zen5x5/ebv-eye_snn_hardware/docs/related_work/2026_FPGA_SNN_Accelerator_Design_Review.md

# 硬件文献阅读入口

当前数值比较集中在 [Tan 与 FPGA 眼动追踪比较](../hardware/comparison.md)，当前数据流集中在 [设计报告](../hardware/current_design.md)。

## 架构参考

- [Tan 2025](https://doi.org/10.1109/TCSI.2025.3553497)：权重驻留、输入重用、计算单元附近保存部分和，帮助计算与存储带宽匹配。
- [SEE 2024](https://arxiv.org/html/2404.14279v1)：事件稀疏卷积在 FPGA 上运行，循环网络与读出在 Arm 上运行。
- [FireFly](https://doi.org/10.1109/TVLSI.2023.3279349)、[FireFly v2](https://arxiv.org/abs/2309.16158)：同为 XCZU3EG 器件族，适合研究并行计算与时间步调度；任务端点为分类。
- [ESDA](https://doi.org/10.1145/3626202.3637558)：稀疏坐标流、行缓冲和计算流水。

当前模型前两层使用事件与非零包流，深层使用共享的规则计算阵列。两步计算相邻执行时复用权重，L3 还复用卷积电流。当前布线资源和频率统一引用当前证据目录。

早期文献审计与设计空间说明保留在 Git 提交 3fef30e。
