zen5x5/ebv-eye_snn_hardware/docs/hardware/figures/ebv_eye_final_pe_bram_dataflow.pdf

EVENT-DRIVEN FRONT END | SHARED PAIRED-TIME BACK END | DENSE HEAD

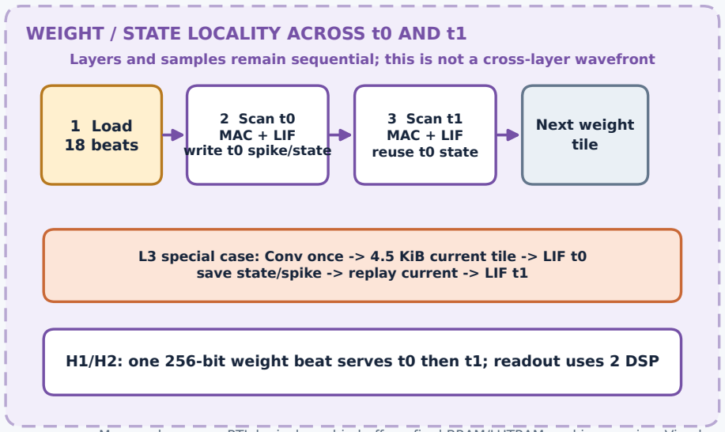
[picture p1: figure]
1 Load 18 beats; 2 Scan t0 MAC + LIF write t0 spike/state; 3 Scan t1 MAC + LIF reuse t0 state; Next weight tile

### WEIGHT / STATE LOCALITY ACROSS t0 AND t1

# EBV-Eye Final RTL: PE and On-Chip-Memory Dataflow

## Event-driven L1/L2, one shared 288-lane deep core, and adjacent t0/t1 execution

400 records

Pool -> constant -> S24 clamp -> stateless LIF

L3 reads once;
replay current

one physical core reused sequentially: L3 -> L4 -> ... -> L8

L4-L8: read previous A/B set; write the other set

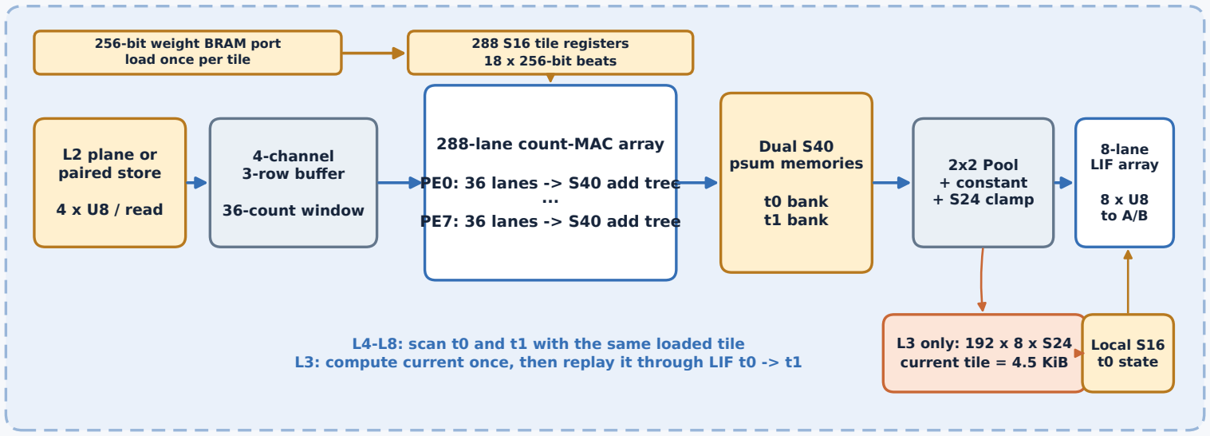
[picture p2: figure]
L2 plane or paired store; 4 x U8 / read; 4-channel 3-row buffer; 36-count window; 288-lane count-MAC array; PE0: 36 lanes -> S40 add tree ... PE7: 36 lanes -> S40 add tree; Dual S40 psum memories; t0 bank t1 bank; 2x2 Pool + constant + S24 clamp; 8-lane LIF array; 288 S16 tile registers 18 x 256-bit beats; 256-bit weight BRAM port load once per tile; L3 only: 192 x 8 x S24 current tile = 4.5 KiB; Local S16 t0 state

L4-L8: scan t0 and t1 with the same loaded tile
L3: compute current once, then replay it through LIF t0 -> t1

Layers and samples remain sequential; this is not a cross-layer wavefront

Memory boxes are RTL logical on-chip buffers; final BRAM/LUTRAM packing requires Vivado.

Sorted unit
events

(pol, row, col)

L1 event PE array

### 72 LUT add lanes 9 taps x 8 OC

Nonzero
U8 packet
FIFO

L2 count-MAC PEs

### 48 DSP lanes 3 taps x 16 OC

3-row / 9-bank S40 psum ring | 3-row / 9-bank S40 psum ring

L2 full plane

### 16 x 24 x 32

U8

### 8 x (2 U8)

banks

L3-L8 shared Conv PEs

### 8 output PEs 36 MAC lanes / PE 2 x S40 psum banks

= 288 DSP

Pool + constant
+ S24 clamp + LIF

S16 t0 state
L3: 4.5 KiB I tile

Paired U8
feature store

t0/t1 x A/B

### 4 sets x 8 banks

576 words/bank

H1 / H2
paired engine

### 16 DSP

Readout

2
DSP

Continuous
gaze

(x, y)

Front-end weight/config storage: L1 144 + L2 1,152 S16 weights | On-chip weight BRAMs -> 256-bit tile loader; parameter RAM -> postprocess

Layer controller / address generator / ready-valid scheduler

L3 special case: Conv once -> 4.5 KiB current tile -> LIF t0 save state/spike -> replay current -> LIF t1

H1/H2: one 256-bit weight beat serves t0 then t1; readout uses 2 DSP

Measured RTL/Yosys evidence | 354 DSP = 48 + 288 + 16 + 2 | 6,060 runtime 256-bit weight reads | 67,942.9 cycles/sample | 80.5 BRAM36-equivalent | 159,408 checked values, 0 mismatch
400 events | T = 2 | S16 W | S40 -> S24

## A Complete sample flow and memory hierarchy

B One deep-convolution tile: PE lanes and local buffers | C | Per-tile execution order
