zen5x5/ebv-eye_snn_hardware/docs/hardware/figures/ebv_eye_event_driven_layer_adjacent_architecture.pdf

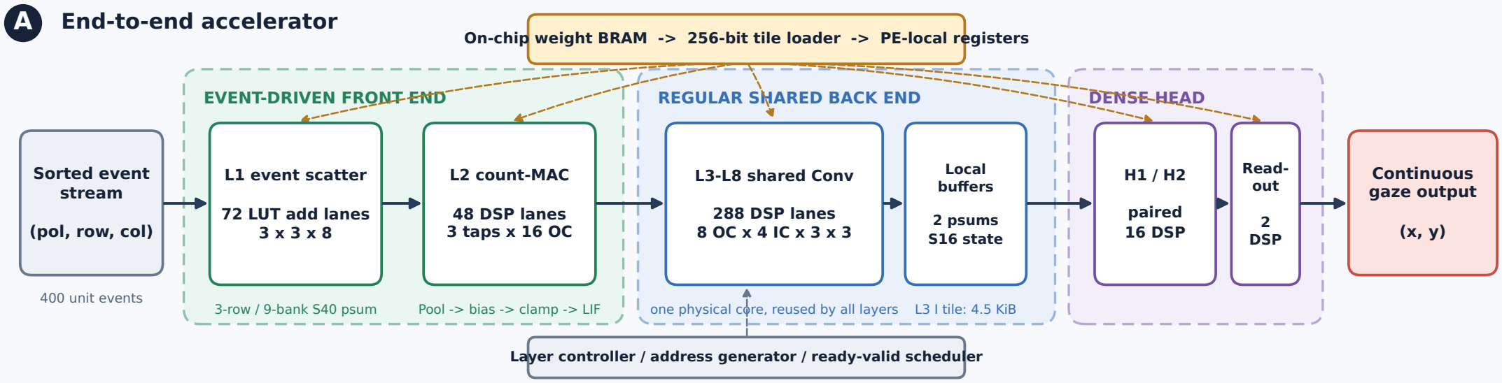
[picture p3: figure]
EVENT-DRIVEN FRONT END; REGULAR SHARED BACK END; DENSE HEAD; A End-to-end accelerator; 400 unit events; Sorted event stream; (pol, row, col); L1 event scatter; 72 LUT add lanes 3 x 3 x 8; L2 count-MAC; 48 DSP lanes 3 taps x 16 OC; L3-L8 shared Conv; 288 DSP lanes 8 OC x 4 IC x 3 x 3; Local buffers; 2 psums S16 state; paired 16 DSP; Read- out; 2 DSP; Continuous gaze output
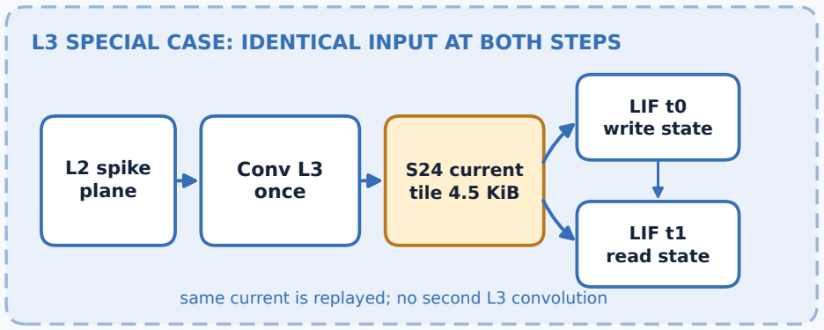
[picture p4: figure]
L2 spike plane; Conv L3 once; S24 current tile 4.5 KiB; LIF t0 write state; LIF t1 read state
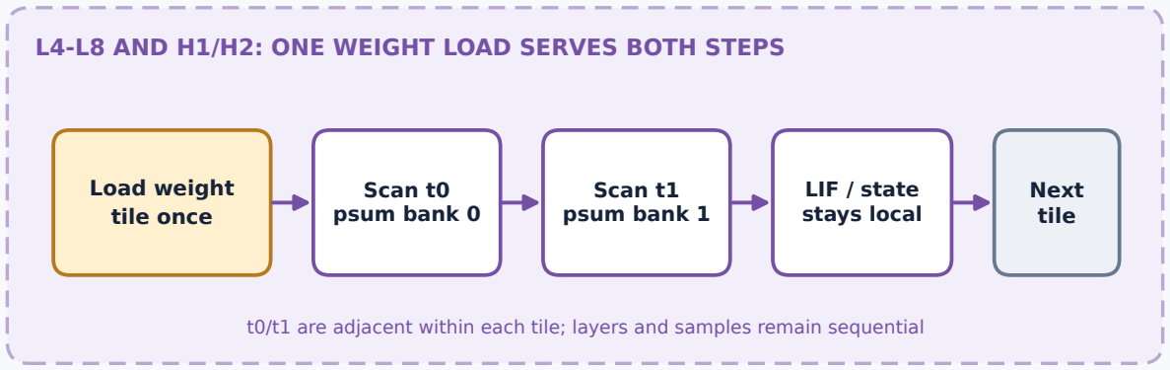
[picture p5: figure]
Load weight tile once; Scan t0 psum bank 0; Scan t1 psum bank 1; LIF / state stays local; Next tile

L3 SPECIAL CASE: IDENTICAL INPUT AT BOTH STEPS | L4-L8 AND H1/H2: ONE WEIGHT LOAD SERVES BOTH STEPS

# EBV-Eye SNN Accelerator

## Event-driven L1/L2 + per-layer adjacent t0/t1 execution

3-row / 9-bank S40 psum | Pool -> bias -> clamp -> LIF | one physical core, reused by all layers L3 I tile: 4.5 KiB

## B Deep-layer schedule: keep weights and state local across t0 / t1

same current is replayed; no second L3 convolution | t0/t1 are adjacent within each tile; layers and samples remain sequential

On-chip weight BRAM -> 256-bit tile loader -> PE-local registers

Layer controller / address generator / ready-valid scheduler

RTL evidence | 7.911M scheduled lanes | 67,942.9 cycles/sample | 345,080,448 checked values, 0 mismatch | Yosys: 354 DSP + 80.5 BRAM36-equivalent
400 events | T = 2 | S16 / S24
