zen5x5/ebv-eye_snn_hardware/docs/hardware/README.md

# 硬件报告

- [当前设计](current_design.md)：400 事件输入、L1 至输出的数据流、存储和逐模块资源。
- [性能比较](comparison.md)：2026-10-17 更新，收录 16 篇独立外部工作；7 篇 FPGA 实现或原型、8 篇 SNN 研究及 Tan 芯片，包含 Retina、NeuroEye 等硬件对照。
- [正式 48 模型量化](06_formal_l40s_quantization.md)：Pursuit/Saccade 各 24 用户的软件定点结果。
- [历史：上 Vivado 前](../history/pre_vivado_20261013.md)。
- [历史：器件实现与结构调整](../history/vivado_development_20261015.md)。
- [机器证据](../../evidence/README.md)与[复现检查](../../VALIDATION.md)。
