zen5x5/ebv-eye_snn_hardware/docs/paper_metrics.md

# 论文硬件指标检查（seed2021 四组真实训练模型）

2026-10-19新增第五档Pursuit L1～L4无状态：已完成定点参考、16输入RTL核验、综合、布局布线和
160MHz完整时序；68,293拍、0.426831ms、120块BRAM36等效。五档时间/BRAM统一取
`results/latency_bram.json`或`.csv`。以下功率和能量仍专指原四档，本轮未要求第五档功耗。

## ISCAS投稿要求与本篇实验范围

2026-10-17核对[ISCAS 2027征稿说明](https://2027.ieee-iscas.org/call-for-papers)及
[官方投稿要求](https://epapers2.org/iscas2027/ESR/authorinfo1.php)。普通论文要求原创研究；
公开要求没有规定所有硬件论文均须上板、流片或进行完整的延迟仿真。
已发表的[NeuroEye，ISCAS 2025](https://doi.org/10.1109/ISCAS56072.2025.11043272)
报告布局布线后的功率与能量评估。以下实验范围根据本篇无状态与计算复用的贡献确定。

本篇完成四组模型的数值正确性、FPGA布局布线、完整时序、资源和拍数比较，
并已完成真实输入活动驱动的功率/能量估算。功耗使用布线后的功能网表执行真实输入，
记录推理窗口内的实际线网活动；未加入逐线SDF传播延时，未捕获延迟差产生的短暂跳变。
四组采用相同的方法、频率、电压、温度与输入。
耗时的逐线延迟仿真已停止，额外产物按用户要求删除。

## 主表应呈现的结果

| 指标 | 当前证据 | 本轮安排 |
| --- | --- | --- |
| 浮点与定点角误差 | 四档×Pursuit/Saccade×24用户共192模型完整test量化齐全；逐用户等权均值见results/quantization/state_depth/results.json | 已补齐；141份新增CPU评估、51份已有结果核验复用 |
| FPGA型号、工具与数值位宽 | XCZU3EG-2、Vivado 2025.2.1、权重/膜16位、脉冲8位 | 四组保持相同 |
| LUT、FF、DSP、BRAM数量与占比 | 四组综合与布线后资源均已完成 | 已补齐 |
| 工作频率与完整时序检查 | 四组均已通过160 MHz建立、保持、脉宽与约束覆盖检查 | 已补齐，DCP独立复核也全部通过 |
| 核心拍数、每样本时间、串行服务率 | 四组16样本RTL核验，拍数固定，160 MHz时序通过 | 已按验证频率换算，输入传输单列 |
| 推理期间平均功率 | user10四组×相同16输入，64次布线后活动仿真及功耗报告已完成 | 已补齐；报告样本均值与变化范围 |
| 每样本能量 | 总能量402.257/331.583/285.527/258.212 µJ，动态与静态分列 | 已补齐；能量=推理期间平均功率×核心时间 |
| 无状态带来的节省 | 四组时间、存储、读写及能量均已核验 | L1～L2相对全状态省25.15%核心时间、28.45%BRAM、29.02%总能量 |

“信号活动记录”记录计算时每根线维持0/1的时间及变化次数，文件格式为SAIF。
本轮功率是布线后电路的工具估算，统计范围为FPGA芯片上的该实现；板卡供电电路、
外部存储、相机和主机功率需在后续整机测量中统计。

本轮活动仿真使用user10各自模型和已经核验的16个validation样本。
四组user10结果单列；24用户平均功耗不列入本篇必做实验。
同一固定电路的拍数、资源和时钟约束随用户切换保持不变，功耗随权重和输入活动变化。
主汇总见[summary.json](../results/summary.json)。
四档双任务24用户完整定点批次见[量化索引](../results/quantization/state_depth/results.json)。
2026-10-19在carbonite CPU完成待补项；浮点沿用原训练报告，定点每人覆盖完整test。

## 速度需要写清楚的范围

核心时间：输入和权重已在片上存储中，从启动计算到结果完成。
四组核心拍数分别为105305、90525、78817、72101。
本轮无跨样本重叠，频率除以核心拍数给出核心连续服务率。

当前32位评估总线每个输入值使用地址、数据各一条命令；24576个输入值共49152条命令。
160 MHz每拍传一条命令时，输入命令发送需要0.307200 ms。
权重/常量初始化共62462条命令：卷积4158×10、全连接1992×10、逐通道参数320×3、
读出小数位2条。初始化一次为0.3903875 ms，可在后续样本之间保留权重。
这些是当前评估接口的命令时间；完整启动/完成/结果读取还有寄存器接口延迟。

逐样本加载与核心计算顺序执行时，至少需要“49152条输入命令+核心拍数”；
完整接口样本间隔还应包含启动、完成确认和读回。这应和核心服务率分别列示。
事件收集400条需要的时间随事件发生速度变化，属于系统输入成窗时间，单独报告。

## 对无状态创新特别有用的补充表

列出每组每层拍数、膜电位容量和每样本读写字节数，直接说明节省发生在哪里。
RTL现已逐层核对状态读写次数和乘加发射次数，可以从记录生成该表。
同时列出为跨步复用保留的电流、特征及部分和缓存，给出整个实现的BRAM总量。
外部论文对比统一标注输出任务、输入窗口、平台、精度、时间范围及验证阶段。

## 本篇选定完成阶段

本篇采用FPGA布局布线和完整时序检查，加真实输入活动的功耗/能量估算。
板上运行与供电测量按用户决定安排到后续期刊扩展。
上述主表用于验证本篇的精度、时间、存储和能量结论。实际最高频率搜索、GOPS峰值、
ASIC流片与板级实测留在本轮范围之外。

方法参考：[AMD UG907：基于SAIF的功耗分析](https://docs.amd.com/r/en-US/ug907-vivado-power-analysis-optimization/Vector-SAIF-Based-Power-Analysis)。
