zen5x5/ebv-eye_snn_hardware/docs/hardware/current_design.md

# 当前硬件设计

更新：2026-10-16。部署候选为 Pursuit user17/seed2022。源代码在 `code/hardware/rtl/`，完整顶层为 `pursuit_sparse_layer_major_accelerator_top.sv`。

## 输入和模型

一个样本连续取得 400 个眼部 ROI 事件。ROI 为 192×256，坐标各除以 2 后，形成 96×128 空间中的两个极性通道。重复地址保留重复事件，送入前按行号排列。

同一完整输入用于两个逻辑时间步 t0、t1。每个逻辑步包含大量 FPGA 时钟。L1/L2 从零状态开始，输出供两个时间步使用；L3 至 H2 保存第一步留下的膜电位。

| 层 | 结构 | 输出尺寸 |
|---|---|---|
| L1 | 2→8，3×3 卷积、2×2 池化、脉冲计算 | 8×48×64 |
| L2 | 8→16，同上 | 16×24×32 |
| L3 | 16→24，同上 | 24×12×16 |
| L4 | 24→32，同上 | 32×6×8 |
| L5 | 32→40，同上 | 40×3×4 |
| L6～L8 | 三层 40→40 卷积、脉冲计算 | 40×3×4 |
| H1、H2 | 脉冲全连接 480→60→12 | 60、12 |
| 输出 | 两步脉冲取均值，12→2 线性读出 | 连续坐标 x、y |

参数总数 96,792。权重为有正负号的 16 位整数，运行部分和为 40 位，电流为 24 位，膜电位为 16 位，脉冲计数为无符号 8 位。

当前 user17 模型在 1,364 个 test 样本上的浮点/定点平均角误差为 0.489147°/0.488592°。该候选按 72 个已训练模型各自 test 误差排序选取，各用户数据不同。正式多用户报告另列 Pursuit/Saccade 各 24 用户等权定点误差 0.825481°/1.326037°。

## 完整数据通路

当前数据通路

1. 主机提前装入权重、每通道常量和小数位设置。
2. L1 消费 400 个单位事件，按权重更新局部卷积部分和，完成池化与脉冲计算，发送非零计数包。
3. L2 对每个非零包执行计数乘权重，再做池化、加常量和脉冲计算，保存完整 16×24×32 输出。
4. L3 对每个 8 输出通道块计算一次卷积电流，放入 4.5 KiB 缓存，连续用于两个时间步的神经元计算。
5. L4～L8 共用同一卷积引擎。每个权重块装入后，依次扫描第一步、第二步输入；两套部分和、局部膜电位与两步特征存储配合保存中间结果。
6. H1/H2 共用 16 路整数计算引擎，每组权重相邻服务两个时间步。
7. 输出层形成两维有符号 64 位整数及缩放设置，外部按小数位和时间步平均系数换算连续坐标。

各深层顺序使用共享引擎，样本按顺序处理。

## L1：事件、计算和存储的顺序

### 接收和加权累加

L1 接收行 7 位、列 7 位、极性 1 位，合计 15 位事件数据。寄存器还保存列号除以 3 的商/余数（6/2 位）、行号余数（2 位）和卷积核组号（4 位）。

144 个 S16 权重共 288 字节，分成 24 个深度为 6 的小存储；8 个常量及小数位设置共 232 位。

24 路加法每次更新 3 个空间位置、每位置 8 个通道。三组覆盖 3×3 支持域；每组先花 1 拍从 BRAM 读出旧值，下一拍加权并写回，所以每事件的更新过程为 6 拍。160 MHz 下为 37.5 ns。

每个位置的 8 个 S40 部分和组成 320 位数据字。三行按行号和列号除以 3 的余数分成 9 个存储组，每组 43 个地址：

```text
组号 = 3 × (行 % 3) + 列 % 3
地址 = 列 // 3
容量 = 9 × 43 × 320 位 = 15,480 字节
```

本次 Vivado 将该累加区安排为 36 RAMB36 + 9 RAMB18，标称容量合计 182.25 KiB。宽数据字和多组并行访问占用了整块存储器。

### 按行池化和脉冲计算

一行卷积值完成后，电路读出相邻两个位置，8 个通道一起比较。上行的横向最大值放入 64×320 位的 LUT 小存储，容量 2.5 KiB；下行到达后完成纵向比较。8 个池化结果保存到 320 位寄存器，下一拍完成加常量、24 位钳位、脉冲和剩余膜电位计算。

位置输出寄存器保存电流 192 位、脉冲 64 位和膜电位 128 位，共 384 位数据。发送寄存器保存脉冲 64 位、地址 12 位、非零通道标记 8 位和发送状态 1 位。非零通道依次以 23 位包交给 L2，接收端忙时保留待发数据。

本次样本的第一个事件为行 1、列 55、极性 0。第 7 输出通道在池化位置 (0,27) 的四个卷积值为 5317、26534、9189、-10898；取最大值得 26534，加常量 927 得 27461。该通道阈值整数为 4096，得到计数 6 和剩余膜电位 2885。

### 本次样本的实测拍数

| 阶段 | 拍数 |
|---|---:|
| 清空累加区 | 43 |
| 输入与换行控制等待 | 156 |
| 事件读取、加法和写回 | 2,400 |
| 读取池化位置 | 6,144 |
| 池化及等待输出腾空 | 35,405 |
| 脉冲计算 | 3,072 |
| 行末输出收尾及外围结束 | 100 |
| L1 合计 | 47,320 |

L1 与 L2 连在一起运行时历时 295.75 µs。该样本有 362 个不同的极性位置，L1 输出 24,576 个计数，其中 3,315 个非零；包内计数总和为 8,728。独立 L1、下游持续接收的测试为 19,816 拍。

## L2 与深层的当前实现

L2 有 48 路 U8 计数乘 S16 权重的运算，16 个输出通道共用一套脉冲计算电路。其 9 个累加存储组每组 22×640 位，共 15.47 KiB，映射为 LUT 分布式存储。完整 L2 脉冲图为 12 KiB，保存在 BRAM，供 L3 读取。

深层卷积阵列每次处理 8 个输出通道、4 个输入通道和 9 个卷积位置，共 288 路乘法。整个共享卷积引擎布线后合计 308 DSP。H1/H2 有 16 路整数计算，输出有 2 路点积计算；本次工具把这两部分安排到 LUT。

两步特征由 t0/t1 × A/B 四组存储保存，逻辑容量共 18 KiB。L3 电流缓存为 4.5 KiB。每样本运行期读取 6,060 个 256 位权重数据字，包含卷积 4,068、线性 1,980、输出 12 次。

## 当前资源、时间和功率

| 模块 | LUT | FF | RAMB36 | RAMB18 | DSP |
|---|---:|---:|---:|---:|---:|
| L1 | 8,842 | 1,523 | 36 | 9 | 0 |
| L2 | 24,466 | 7,519 | 9 | 8 | 0 |
| 共享卷积引擎 | 16,641 | 10,962 | 29 | 3 | 308 |
| 两步特征存储 | 1,791 | 6 | 0 | 32 | 0 |
| H1/H2 引擎 | 9,176 | 2,885 | 0 | 0 | 0 |
| 输出引擎 | 730 | 270 | 0 | 0 | 0 |
| 顶层合计 | 61,657 | 24,835 | 124 | 54 | 308 |

顶层还包含权重、参数和控制电路。LUT 可能跨模块合并，完整层级统计见原始资源报告。

```text
整网 = 104,005 拍
前端 = 51,305 拍；共享卷积 = 48,609 拍；全连接 = 4,074 拍
其余交接控制 = 17 拍

核心时间 = 104,005 / 160,000,000 = 0.65003125 ms
连续串行服务率 = 160,000,000 / 104,005 ≈ 1,538 次/秒
```

器件实现按 5 ns 目标布线，setup 余量 -1.109 ns；同一布线结果覆盖为 6.25 ns 后，setup/hold 余量为 +0.141/+0.040 ns。OOC 是单独实现加速器核心，板级接口留待集成。

Vivado 给出的总片上功率为 1.835 W，其中动态 1.608 W、静态 0.228 W，标记 Medium 置信度，采用默认活动估计。按该功率与核心时间相乘，每样本能量估算为 1.192807 mJ。板上活动和功率测量是后续确认这两项的步骤。

## 证据

- [整网功能回放与 L1 计数](../../evidence/current/rtl_replay/report.json)。
- [量化结果](../../evidence/current/quantization/pursuit/user17/summary.json)。
- [布线后资源](../../evidence/current/vivado/reports/post_route_utilization.rpt)。
- [160 MHz 时序](../../evidence/current/vivado/reports/post_route_timing_160mhz.rpt)。
- [工具功率](../../evidence/current/vivado/reports/post_route_power_vectorless_160mhz.rpt)。
- [对外性能比较](comparison.md)。
