zen5x5/ebv-eye_snn_hardware/docs/hardware/01_pursuit_l1_l2_stateless_pre_eda_design.md

# Pursuit L1/L2无状态SNN：上EDA前的语义、dataflow与验证方案

## 当前判断

最适合当前一周到三周时间窗的目标，是“定点参考＋真实尺寸关键浅层 RTL＋
同一映射下全状态/无状态综合对比＋真实输入回放计数”。首个公平对照应采用
同一套时间优先 dataflow：全状态模型和 L1/L2 无状态模型都计算两个时间步，
只改变跨步膜的保留与访问。重复输入带来的计算复用另列为第二个优化结果，
避免把状态删除与 dataflow 优化混成一个数字。

截至 2026-10-06，已完成上 EDA 前的模型语义核对、逐层存储账、候选
dataflow、验证边界，以及 3 个 seed × 2 种状态配置 × train/validation 的
12 组浮点数值范围审计。用户已确认先做FS-TM/SL-TM公平对照，再增加SL-HYB
复用；层内驻留、稀疏性和PE设计空间见[02文档](02_pursuit_dataflow_pe_and_channel_design_space.md)。
train 部分扫描的是正式缓存中的物理来源窗，不是
训练时逐 epoch 随机生成的 200+200 重组样本。本文件保留冻结前设计依据；
后续已经完成S16/S24/S16定点、两套golden vectors、完整L1～readout RTL、
FS-TM/SL-TM/SL-HYB状态机和整网逐值回放，见[03文档](03_pursuit_fixed_point_and_parallel_core.md)
与[04文档](04_pursuit_complete_pre_vivado_rtl.md)。2026-10-08又实现L1/L2
事件驱动的Sparse-TM及层内相邻两步的Sparse-LM-A，见
[05文档](05_pursuit_sparse_frontend_and_layer_major_rtl.md)。本文保留最初的
设计与验证依据；当前仍没有Vivado布局布线、WNS、功耗或上板数字。

## 固定的推理合同

每个样本由 ROI 内 400 个事件形成 `2×96×128` 双极性计数图，在两个内部
逻辑步 `t0,t1` 完整重复。每个新样本开始前清空全部膜状态；两个逻辑步不是
两个 FPGA 时钟，也不是两批新事件。

卷积层 L1～L5 为 `Conv(no bias)→BN→MaxPool→LIF`，L6～L8 为
`Conv(no bias)→BN→LIF`。随后是 `480→60→12` 两个脉冲全连接层；H2 的两个
时间步脉冲先精确除以 2，再送入无 bias 的 `12→2` 连续读出。

将 BN 输出和阈值归一化后的当前步电流记为 `I_t`，逐神经元语义为：

```text
u_t = 0.75 * v_(t-1) + I_t
s_t = max(floor(u_t), 0)
v_t = max(u_t - s_t, -1)
```

`s_t` 是非负整数 MultiSpike 计数，没有由模型定义的有限上界。L1/L2 在
`t0→t1` 边界清空膜，其他层保留；因此 L1/L2 对两个重复输入必须产生完全
相同的输出。L1/L2 的 `t1` 后残余膜没有消费者，硬件无需物化。训练使用的
PeriodicExponential surrogate gradient 不进入推理电路。

对每个输出通道，BN、阈值和无 bias 卷积可折叠为：

```text
a  = gamma / (sqrt(running_var + eps) * theta)
W' = a * W
b' = (beta - gamma * running_mean / sqrt(running_var + eps)) / theta
```

所以原卷积没有 bias，不表示电路没有逐通道常量 `b'`。前五层仍必须保持
“完成本步卷积与归一化电流→MaxPool→LIF”的顺序。

## 逐层尺寸、参数和跨步状态

下表的“卷积/线性输出”与“LIF位置”均是单个逻辑步的元素数。常量是折叠后
每个输出通道或神经元一个；参数均不含膜状态。

| 层 | 卷积/线性输出 | Pool后/LIF位置 | 权重 | 折叠常量 | 全状态跨步膜 | 最终跨步膜 |
|---|---:|---:|---:|---:|---:|---:|
| 输入 | 24,576 | 24,576 | 0 | 0 | 0 | 0 |
| L1, 2→8 | 98,304 | 24,576 | 144 | 8 | 24,576 | 0 |
| L2, 8→16 | 49,152 | 12,288 | 1,152 | 16 | 12,288 | 0 |
| L3, 16→24 | 18,432 | 4,608 | 3,456 | 24 | 4,608 | 4,608 |
| L4, 24→32 | 6,144 | 1,536 | 6,912 | 32 | 1,536 | 1,536 |
| L5, 32→40 | 1,920 | 480 | 11,520 | 40 | 480 | 480 |
| L6, 40→40 | 480 | 480 | 14,400 | 40 | 480 | 480 |
| L7, 40→40 | 480 | 480 | 14,400 | 40 | 480 | 480 |
| L8, 40→40 | 480 | 480 | 14,400 | 40 | 480 | 480 |
| H1, 480→60 | 60 | 60 | 28,800 | 60 | 60 | 60 |
| H2, 60→12 | 12 | 12 | 720 | 12 | 12 | 12 |
| Readout, 12→2 | 2 | 2 | 24 | 0 | 0 | 0 |
| **合计** | — | — | **95,928** | **312** | **45,000** | **8,136** |

若权重和常量暂按 16 bit，95,928 个权重加 312 个常量共 187.97 KiB；这只是
容量换算，不代表最终 BRAM 映射。跨步膜按 16 bit 时，全状态为 87.89 KiB，
最终模型为 15.89 KiB。时间优先且边界一次写加一次读时，相应跨步膜流量为
175.78 KiB/样本和 31.78 KiB/样本，差值 144 KiB。该差值只属于这项映射
假设，不能写成总存储或总能耗下降 81.92%。

## 公平对照与计算复用

建议按三档分别实现和报告：

| 名称 | 调度 | 两步浅层计算 | 跨步状态 | 用途 |
|---|---|---|---|---|
| FS-TM | `t0`整网后`t1`整网 | 都执行 | L1～H2，共45,000 | 全状态基线 |
| SL-TM | 与FS-TM完全相同 | 都执行 | L3～H2，共8,136 | 单独测状态删除收益 |
| SL-HYB | `t0`算浅层并缓存边界，`t1`复用 | 复用L1/L2前缀 | L3～H2，共8,136 | 单列重复输入优化 |

全状态模型也应获得重复输入允许的优化：它可以缓存 L1 的当前步输入电流，
但因 L1 膜保留，不能直接复用 L1 脉冲。最终无状态模型的 L1、L2 输出均在
两步相同，可选择两个复用边界：

- 缓存 L2 脉冲：容量为 `12,288*b_s` bit，即 `1,536*b_s` byte；若脉冲计数
  为 8 bit，需要 12 KiB。
- 缓存 L3 的 Pool 后、LIF 前电流：容量为 `4,608*b_i` bit，即
  `576*b_i` byte；若电流为 16 bit，需要 9 KiB，并能跳过第二步从输入到
  L3 电流生成的全部计算。

L3 电流缓存小于 L2 脉冲缓存的条件是 `b_i < (8/3)*b_s`。位宽未冻结前，
不能只凭示例确定边界。

整网单步稠密 Conv＋Linear 为 10.391M MAC，两步为约 20.781M MAC。缓存 L3
电流可省去第二步 L1～L3 的 7.963M 稠密 MAC。按现有脉冲活动估算，原始两步
SynOps 为 7.290±0.447M；缓存 L2 脉冲后约 6.476±0.368M，缓存 L3 电流后约
5.196±0.258M。这些数值不是周期、功耗或 FPGA 实测。

纯粹按层处理两个时间步可以把每层状态局部化，但会引入两步激活缓存，并使
45,000→8,136 的物理 RAM 对比依赖另一套映射。它可作为 dataflow 敏感性
分析，不适合作为唯一的全状态/无状态比较。

## 空间计算与首版核心

一周版本建议使用规则的分块稠密共享卷积核心，首个候选输出通道并行度为
`P_OC=8`。原因是它能先建立确定的周期、RAM 和时序账，并覆盖真实的
L1→L2→L3 尺寸。若直接把 SynOps 映射成稀疏 scatter，仍需提供部分和/当前
累加器、地址路由和输出初始化；折叠常量还可能使没有输入脉冲的位置发放，
因此不能假设“无事件就完全不访问输出”。稀疏版本可在规则核心正确后评估。

候选模块边界为：

```text
input loader
  -> scheduler
  -> shared conv + folded affine + pool
  -> MultiSpike LIF
  -> ping-pong activation RAM
  -> H1/H2 + temporal mean + readout

state RAM: FS存L1～H2；SL存L3～H2
perf monitor: 周期、状态读写、激活读写、权重读、有效累加
```

可综合核心保持器件无关，另设 `core_synth_top`；AUP-ZU3 回放另设
`aup_zu3_replay_top`，以后需要 PS/AXI 时再加 wrapper。这样行为仿真不依赖
板卡文件，综合和布局布线才绑定具体器件。

## 浮点数值范围审计

审计扫描 3 个 seed 的全状态 epoch100 与 L1/L2 无状态续训 epoch200，分别
覆盖正式缓存中的物理 train 来源窗和 validation，共 12 组；它不生成训练时
的逐 epoch 随机重组样本。位宽校准不读取 test。下表给出所有 12 组的并集
极值；`I`、`u` 和 `v` 均在阈值归一化域。逐 seed 原始 JSON 保存在
`/data/xuzx/result/ebv-eye/pursuit/fixed_event_window/hardware/numeric_range_profile_20261006/`；
每份均记录分析脚本、checkpoint、configuration 和缓存 SHA-256。

| 层 | `I_min` | `I_max` | `u_min` | `u_max` | 复位后`v` | 最大MultiSpike |
|---|---:|---:|---:|---:|---:|---:|
| L1 | -95.3456 | 173.3320 | -96.0424 | 173.3320 | [-1, 1) | 173 |
| L2 | -101.4628 | 123.6798 | -101.4628 | 123.6798 | [-1, 1) | 123 |
| L3 | -64.3635 | 62.3081 | -65.1135 | 62.5392 | [-1, 1) | 62 |
| L4 | -25.6895 | 62.5325 | -26.4395 | 62.8771 | [-1, 1) | 62 |
| L5 | -10.0655 | 34.4135 | -10.8155 | 35.0256 | [-1, 1) | 35 |
| L6 | -22.1116 | 18.6504 | -22.8616 | 18.6504 | [-1, 1) | 18 |
| L7 | -19.1210 | 14.5445 | -19.8710 | 15.1159 | [-1, 1) | 15 |
| L8 | -7.0105 | 6.7712 | -7.7605 | 7.1810 | [-1, 1) | 7 |
| H1 | -55.2900 | 71.4315 | -56.0400 | 72.0430 | [-1, 1) | 72 |
| H2 | -35.5900 | 68.8574 | -36.3400 | 68.9531 | [-1, 1) | 68 |

输入每像素计数在 train/validation 的并集最大值为 29；接口仍应按每个样本
最多 400 个事件的理论上界保留 U9，除非后续明确采用饱和协议。校准集里的
最大脉冲计数 173 可装入 U8，但 MultiSpike 在模型定义上无界，因此还需用
定点累加器上界、饱和规则和误差实验共同冻结脉冲位宽。

折叠参数的三 seed、两状态模型并集如下：

| 层 | `theta_min..max` | `W'_min..max` | `b'_min..max` |
|---|---:|---:|---:|
| L1 | 0.89614..1.18414 | -4.22894..4.92700 | -0.40976..0.69614 |
| L2 | 0.53282..1.16754 | -0.46329..0.42531 | -0.46614..2.33728 |
| L3 | 0.51734..1.19223 | -0.45321..0.31703 | -1.96495..3.64654 |
| L4 | 0.64953..1.03954 | -0.48768..0.34393 | -0.96559..4.39539 |
| L5 | 0.69357..0.94420 | -0.26198..0.26632 | -1.51601..2.72415 |
| L6 | 0.55276..0.92909 | -0.25532..0.23085 | -2.76274..2.95681 |
| L7 | 0.56251..1.06845 | -0.60105..0.28892 | -1.46836..3.59475 |
| L8 | 0.73361..1.03478 | -0.28315..0.12863 | 0.27142..2.77898 |
| H1 | 0.71188..1.45369 | -2.48261..0.92398 | -0.12096..0.47369 |
| H2 | 1.00252..1.78465 | -1.18707..0.27326 | -0.12995..0.44882 |
| Readout | — | -0.16771..0.14402 | — |

L1 与深层的权重范围相差明显，首轮定点设计应比较逐层或逐输出通道 scale，
不宜直接假设一个全局 scale 足够。

范围脚本用便携的 CPU Sinabs 后端。它的三 seed validation 均值与已保存的
Exodus GPU 端点存在小差异：最终无状态模型为 14.872±0.376 px、
0.7466±0.0226°，已保存端点为 14.75±0.27 px、0.740±0.015°；全状态模型
分别为 14.852±0.619 px、0.7397±0.0263° 与 14.83±0.30 px、
0.740±0.012°。因此当前脚本只用于范围审计。生成 bit-exact golden vector 前，
必须明确冻结数学参考，并用同一参考报告定点误差。

## AUP-ZU3和工具边界

目标板为 RealDigital AUP-ZU3，器件固定为 `XCZU3EG-2SFVC784E`。本阶段最初
建议用板载100 MHz PL时钟起步；后续完整RTL的Vivado OOC目标已锁定5 ns，
200 MHz只在布局布线WNS非负后成立。AMD 的
[AUP-ZU3页面](https://www.amd.com/de/corporate/university-program/aup-boards/realdigital-aup-zu3.html)
给出 154K logic cells、360 DSP 和 9.4 Mb 片上 RAM；
[官方板卡仓库](https://github.com/Xilinx/AUP-ZU3)当前参考工程使用 Vivado
2024.1。Vivado Basic 支持 XCZU3EG。

2026-10-06进入本阶段时服务器尚未发现Vivado或开源RTL工具；随后已建立独立
环境并完成Icarus、Verilator和Yosys验收。当前服务器仍无Vivado。器件相关综合、
实现和时序需要有Vivado的机器，上板只承担最后的真实回放验证；当前目标不需要
ASIC EDA。

## 验证产物与验收条件

定点参考需输出 NPZ、逐端口 MEM 和 manifest。manifest 至少记录 checkpoint、
configuration、缓存和各向量的 SHA-256，张量布局、定点格式、舍入、饱和、
alpha0.75 计算顺序，以及 FS/SL 模式。首轮向量建议使用 16 个 validation 样本，
再加全零、边界值和最大输入等合成样本。

RTL 与参考的验收条件为：

1. 每层脉冲、保留膜和最终 gaze 定点结果逐项 bit-exact；
2. FS/SL 在相同位宽、PE 数、时钟和 RAM 推断方式下比较；
3. 状态读写计数与 45,000/8,136 元素账一致，其他 RAM 流量分项报告；
4. 对 `xczu3eg-sfvc784-2-e` 完成综合和布局布线，100 MHz 下
   `WNS>=0`、`WHS>=0`，无未约束路径和 error DRC；
5. 资源报告列 LUT、FF、BRAM、URAM、DSP，延迟列周期与换算时间；功耗若只有
   工具估计，明确输入活动和估计范围。

## 时间范围

一周可争取完成：定点语义与位宽基线、golden vector、真实尺寸 L1→L3 核心、
FS-TM/SL-TM bit-exact 仿真、状态/访存计数，以及同器件综合；若时序顺利，再
做布局布线。两至三周可继续整网调度、SL-HYB 复用、更多位宽对照、完整实现
后的时序与功耗估计，以及 AUP-ZU3 离线回放。传感器实时接入和 ASIC 物理设计
不属于当前时间窗。

这是2026-10-06当时确认的实施顺序：规则分块共享卷积核心先做FS-TM/SL-TM
公平对照，再增加L3输入缓存的SL-HYB；随后完成的Sparse-TM与Sparse-LM-A
及其当前证据见05文档。`P_OC=8`仍是已实现设计点，不写成跨设计空间测得的
全局最优点。
