zen5x5/ebv-eye_snn_hardware/docs/hardware/02_pursuit_dataflow_pe_and_channel_design_space.md

# Pursuit硬件dataflow、PE与逐通道设计空间

## 当前结论

2026-10-08论文写作补充：共享raster RTL保留为位精确、状态RAM与跨步复用
对照基线；随后已实现“浅层稀疏、深层规则”的`Sparse-TM`，以及让深层每个
权重tile相邻服务`t0/t1`的`Sparse-LM-A`方案A。方案A是单个共享核心的层内
时间复用，不是跨层波前。三路线正式对照见05报告；下文早期“下一步只剩
Vivado”的描述只适用于当时的稠密基线。

FS-TM、SL-TM和SL-HYB只描述两个SNN逻辑步怎样安排，用来区分“删除状态”与
“复用重复计算”。它们不是完整的卷积dataflow。完整设计还需决定八个卷积层
循环的顺序、每类数据驻留位置、片上RAM分 bank、稀疏调度以及PE并行维度。

当前建议采用分层混合驻留，而不是只选一种教科书标签：

1. 整网95,928个权重驻留片上BRAM；
2. 当前层输入使用3行缓冲，重复利用重叠的3×3窗口；
3. 当前输出通道的部分和驻留PE寄存器，累加完成后才写出；
4. 当前输出通道组的权重从分bank的片上权重RAM连续读取；
5. MaxPool边计算边归并，不保存完整的Pool前特征图；
6. 膜状态单独存储，FS保存L1～H2，SL只保存L3～H2；
7. 主论文比较保持时间优先，层优先作为dataflow敏感性分析；
8. L1/L2评估稀疏或跳零，L3以后先使用规则稠密调度。

当前还没有“必须使用多少PE”的唯一数字。一个乘法通道也能完成整网，只是很
慢；所需数量由目标计算延迟、100 MHz下的真实周期、RAM端口和Vivado资源共同
决定。早期32通道点只用于建立解析模型；位宽和微核审计后，首版已改为
完整3×3并行的`8/2/9`与`8/4/9`，即144/288个DSP乘法通道。前者是时序
回退，后者是速度目标，完整结果见03报告。

## “驻留”究竟是什么

卷积可以写成：

```text
for oy, ox, oc:
    psum = folded_constant[oc]
    for ic, ky, kx:
        psum += input[ic, oy+ky, ox+kx] * weight[oc, ic, ky, kx]
```

改变循环内外顺序，就会改变哪种数据能留在离计算器最近的位置：

| 名称 | 留在近端的数据 | 优点 | 本模型中的问题 |
|---|---|---|---|
| 权重驻留 | 当前权重块 | 同一权重跨空间位置重复使用 | 若输出通道块放最外层，输入特征图会为每个块重新扫描 |
| 输入驻留 | 当前输入窗口 | 一个3×3窗口可供全部输出通道使用 | 需要高带宽、分bank的权重RAM |
| 输出驻留 | 当前输出部分和 | 避免宽累加器反复读写RAM | 每个并行输出需要独立累加器 |
| 行驻留 | 3行输入及局部权重/部分和 | 同时利用窗口重叠和局部复用 | 控制和边界处理比纯循环更复杂 |

这些方式可以在不同存储层级同时存在。例如“整网权重驻留片上BRAM＋输入行驻留
line buffer＋输出部分和驻留PE寄存器”并不矛盾。论文需要写清驻留在哪一级，
不能只贴一个weight-stationary标签。

## 两种层内循环顺序

### 输出通道块在外：权重块更近

```text
for oc_tile:
    选择8个输出通道的权重
    for oy, ox:
        从行缓冲形成输入窗口
        在8个PE中完成部分和
```

它只需保存8个通道的权重块和Pool状态，控制简单；代价是每个输出通道块都要
重新扫描输入特征图。`P_OC=8`时，八个卷积层一个逻辑步共读取约143,904个源
特征元素；按16 bit为281.06 KiB，两个逻辑步为562.13 KiB。

### 空间窗口在外：输入窗口更近

```text
for oy, ox:
    输入窗口留在行缓冲
    for oc_tile:
        流入对应权重并完成8个输出部分和
```

一个逻辑步只需从激活RAM读取约69,024个源特征元素；按16 bit为134.81 KiB，
两个逻辑步为269.63 KiB。它减少约52%的这一级激活读取，但需要权重RAM持续
提供并行带宽，并为更多输出通道维护Pool行状态。当前最大Pool行缓存仍约2 KiB，
因此该方案值得在周期模型中优先比较。

以上都是片上流量，不是DDR流量。按当前16-bit容量账，整网权重和常量约
187.97 KiB；全状态时间优先方案连同激活缓冲和膜状态约371.86 KiB，最终
无状态约299.86 KiB，加入L3输入缓存约308.86 KiB。均低于AUP-ZU3公布的
9.4 Mb片上RAM总量，但还未计BRAM宽度、端口和碎片，必须由Vivado确认。

## 跨时间步调度

| 调度 | 权重复用 | 激活缓冲 | 状态物理化 | 论文用途 |
|---|---|---|---|---|
| FS-TM/SL-TM时间优先 | 每层在两个逻辑步各执行一次 | 单时间步ping-pong | 直接体现45,000/8,136个跨步状态 | 主公平对照 |
| 层优先 | 同一层连续处理`t0,t1`，权重更容易保留 | 通常需保存两步激活 | 当前层状态可局部保留，会弱化全局状态RAM差异 | dataflow敏感性分析 |
| SL-HYB | L1～L3输入生成一次 | 增加4,608个L3输入缓存 | 保留8,136个深层状态 | 无状态后的优化结果 |

层优先不是错误方案，但若只报告它，浅层膜状态本来就可能一直留在局部寄存器，
无法直接证明81.92%的逻辑状态删除变成相应物理RAM收益。因此主对照先用时间
优先，层优先再回答“换dataflow后结论是否仍成立”。

## 逐通道活动告诉我们的事情

统计覆盖最终L1/L2无状态模型的三个seed、426个validation物理样本。活动仅用于
硬件调度设计，不替代正式Exodus性能端点。

| 层 | 平均非零位置比例 | 单通道范围 | 最大通道/通道均值的脉冲负载 | 折叠权重逐输出通道最大幅值比 |
|---|---:|---:|---:|---:|
| L1 | 10.4% | 4.9%～15.2% | 1.67× | 2.3× |
| L2 | 30.2% | 10.3%～86.3% | 3.37× | 3.1× |
| L3 | 47.5% | 13.9%～86.0% | 2.49× | 4.8× |
| L4 | 52.8% | 18.8%～85.4% | 1.84× | 4.3× |
| L5 | 55.3% | 29.1%～78.4% | 1.54× | 2.0× |
| L6 | 30.4% | 18.5%～46.0% | 1.66× | 3.1× |
| L7 | 35.9% | 17.6%～46.4% | 1.78× | 6.7× |
| L8 | 32.8% | 8.9%～45.3% | 1.49× | 3.1× |
| H1 | 32.1% | 0%～100% | 6.24× | 33.7× |
| H2 | 29.6% | 0%～91.9% | 4.05× | 6.2× |

两个输入极性通道每个位置的非零比例只有1.13%和1.68%。现有活动分析还显示，
从输入脉冲扇出看，L1约79.9%的输出位置没有被突触触及，L2约57.1%，而L3
以后几乎所有位置都被触及。因此：

- 输入→L1以及L1→L2最值得评估事件驱动或跳零；
- L3以后单纯使用事件地址路由的收益较弱，规则稠密/零跳过更稳妥；
- L2逐源通道SynOps负载最大可达均值3.30倍，静态把一个活跃通道固定给一个PE
  会产生负载不均衡；稀疏方案需轮转、交错或工作队列；
- H1/H2在单个validation和seed中存在零发放通道，但不能凭此永久剪枝；共享PE
  可以动态跳过零输入，而不改变模型结构。

折叠后的浮点权重没有任何精确零，因此目前没有免费权重稀疏性。量化后出现的
零权重能否利用，要等定点实验，不能先假设。部分层的逐输出通道权重幅值相差
4～34倍，支持比较逐输出通道scale；但每个通道使用不同位宽会显著增加打包和
控制复杂度，首轮先保持每层统一位宽、逐输出通道scale或移位。

## 支撑L1/L2状态边界的观测（2026-10-08）

空间调度与状态保留分别由活动分布和容量—精度取舍支撑。这里整理已有模型的
统计，不新建监督缓存、不训练，也没有运行新的状态干预实验。

| 层 | 全状态架构中的膜元素数及占比 | 最终模型第一步非零位置 | 最终模型第二步非零位置 | 最终模型第一步/第二步发放量（脉冲单位/样本） |
|---|---:|---:|---:|---:|
| L1 | 24,576（54.61%） | 10.4% | 10.4% | 5,496.9 / 5,496.9 |
| L2 | 12,288（27.31%） | 30.2% | 30.2% | 6,126.8 / 6,126.8 |
| L3 | 4,608（10.24%） | 37.9% | 57.1% | 2,672.4 / 4,082.3 |

容量来自正式全状态架构，活动来自最终L1/L2无状态三seed模型在426个
user15 eye0 pursuit validation物理窗上的CPU Sinabs逐步剖析。
数据源为`channel_profile_20261006/l1_l2_stateless/seed2021～2023/validation.json`
中的`layer_statistics.Ln.spike_per_channel_by_timestep`：同层各通道的
`nonzero_fraction`取均值，再对三个seed等权平均；`sum_per_sample`先对通道
求和，再对三个seed平均。MultiSpike发放量按整数脉冲单位求和，不是非零位置数。

L1/L2两步无状态且输入重复，所以其脉冲逐值相同，L3归一化电流也相同。
L3第二步非零位置比例和发放量改变，因此这里确实存在由保留膜历史引起的
跨步整合；后面的层还同时受到上游脉冲变化影响，不能将其活动变化全部分配给
各层自身的膜。这个观测展示深层状态的实际表达作用，不将发放增多写成精度增益，
也不把最终模型浅层两步相同当作浅层状态原本无作用的证明。

选择L1/L2的直接依据是：两层集中81.92%全模型膜容量，已有同epoch100起点、
同200轮预算的三seed续训曲线在L1无状态后将L2无状态通道从0增到4/8/12/16，
validation角误差为0.741/0.763/0.757/0.743/0.740°，全状态参考0.740°。
因此整层边界在已测范围内取得最大容量削减、规则控制和相同validation精度。
保留的L3作为仅占10.24%原膜容量的首个深层积分阶段，能在相同电流下形成不同
的第二步表达。再深入删除状态属于另一取舍，不声称已测到L3及更深层的精度崩溃边界。

空间支持率的79.9%/57.1%来自既有`analysis/activity_validation.json`的
`per_layer.L1/L2.untouched_position_fraction`，按三seed等权平均得到
79.8864%/57.0957%。代码`convolution_touched_positions`先做3×3输入支持扩张，
再对有Pool的层做2×2支持合并，因此分母是Pool后的目标神经元位置，而不是
Pool前卷积部分和位置；L3～H2的未触及比例在这批统计中均为0。
未触及只表示没有上游非零输入扇出，折叠常量和保留膜仍需正确处理。

若后续需要进一步解释层间状态敏感性，建议只在现有全状态checkpoint的
validation上做逐层单独清状态的前向诊断，同时统计第二步膜历史改变的脉冲位置
比例和误差变化。使用user15三个seed即可，冻结权重、不重训；这仍是待讨论
分析，不作为已经完成的证据。

## PE怎样定义和选择

### PE是否必须含乘法器

不必须。模型中的输入计数和MultiSpike输出都是非负整数。对任意定点权重`w`和
脉冲计数`n`，突触贡献可以三种方式实现：

```text
乘法：          product = n * w
逐脉冲加法：    product = w + w + ... + w       共n次
二进制移位加法：product = sum(bit_i(n) * (w << i))
```

若使用足够宽的有符号累加器，并且只在最后统一舍入/饱和，三者可保持同一定点
数学结果。若每次加法都提前饱和，则逐脉冲实现可能与一次乘法不同，不能接受
这种隐式语义变化。

三seed最终无状态模型的全部validation活动给出以下每样本均值±样本标准差；
readout也按H2两步脉冲和累加权重、最后除以2的等价形式计入：

| 突触算术 | 原始T=2 | SL-HYB浅层复用后 | 需要通用乘法器 |
|---|---:|---:|---|
| 全稠密MAC | 20.781M | 12.819M | 是 |
| 非零计数×权重 | 4.196±0.268M | 3.037±0.165M | 是 |
| 二进制移位权重项 | 4.690±0.286M | 3.383±0.180M | 否，需移位与加法 |
| 逐单位脉冲加权累加 | 7.291±0.447M | 5.196±0.258M | 否，只需有符号加法 |

所以现有SynOps正好对应“逐单位脉冲加一次权重”的add-only实现。它比全稠密
MAC少很多操作，但相对“每个非零计数只乘一次权重”平均多约74%的突触操作；
二进制移位加法位于两者之间。操作个数仍不能直接换成周期或能量：DSP乘法可
流水到每拍一次，而事件加法还要支付地址路由、bank冲突和随机累加代价。

L1模型接口本身不是二值事件：400条传感器事件先按2×2空间SumPool映射地址，
再把重复`(x,y,polarity)`累加成`2×96×128`整数计数图；正式数据单位置可大于1。
因此L1和L2在卷积口的算术语义相同，都是整数`n`乘权重，不能仅凭层号决定
add-only或DSP。L1额外拥有一种输入表示选择：模型丢弃事件顺序和时间戳，硬件
可以不物化计数图，直接保存并消费400个池化后事件地址；每条记录贡献一次权重，
重复地址就重复累加，数学上严格等价于先构造计数图再算`n*w`。这种实现仍需
解决L1 Pool前累加器、重复地址、折叠常量和清零开销。

三seed validation在浅层复用后的每样本均值进一步说明选择应由工作量决定：
`input→L1`为28.679k次逐单位加法或24.711k次非零计数乘法，前者仅为后者
1.16倍；`L1→L2`则为785.234k次逐单位加法或364.499k次非零计数乘法，前者
为后者2.15倍。因而L2使用DSP计数乘法的吞吐动机更强，但这来自实际计数分布，
不是因为L1输入只能取0/1。

`alpha=0.75`也不需要通用乘法器，可实现为移位减法；H2时间平均是右移一位。
因此整网可以构造为add-only事件机器，但在有360个DSP48的AUP-ZU3上，强制
不用DSP不一定更快或更省。当前改为并行比较三种算术微架构，再决定L1/L2是否
使用add-only前端、深层是否使用计数乘权重核心。

下面原有`P_OC/P_IC/P_K`表描述的是乘法通道核心；add-only核心将另外报告加法
lane数、事件吞吐、累加器bank冲突和实际周期，二者不能共用一个“PE数量”。

“一个PE”没有统一行业定义。这里明确为：一个输出PE保留一个输出部分和，内部
含 `P_IC*P_K` 条乘法通道；共享核心共 `P_OC` 个输出PE，总乘法通道为：

```text
multiplier_lanes = P_OC * P_IC * P_K
```

- `P_OC`：同时计算的输出通道数；
- `P_IC`：每个输出PE每拍读取的输入通道数；
- `P_K`：每个输入通道每拍展开的3×3 kernel tap数。

解析模型枚举了47个不超过128条乘法通道的候选。下表使用100 MHz、权重/激活
16 bit、每条乘法通道暂按一个DSP48，只给MAC调度下界：

| P_OC | P_IC | P_K | 输出PE | 乘法通道/DSP假设 | FS/SL两步下界 | SL-HYB下界 | 算术通道利用率 |
|---:|---:|---:|---:|---:|---:|---:|---:|
| 4 | 2 | 1 | 4 | 8 | 25.98 ms | 16.02 ms | 100.0% |
| 8 | 2 | 1 | 8 | 16 | 12.99 ms | 8.01 ms | 100.0% |
| 8 | 4 | 1 | 8 | 32 | 7.60 ms | 4.56 ms | 85.4% |
| 8 | 2 | 3 | 8 | 48 | 4.33 ms | 2.67 ms | 100.0% |
| 8 | 4 | 3 | 8 | 96 | 2.53 ms | 1.52 ms | 85.4% |

`P_OC=8`适合卷积层，因为8、16、24、32、40都能整除8。32通道候选每拍需广播
4个16-bit激活、读取32个16-bit权重，并在8个32-bit部分和寄存器中累加；即
64-bit激活带宽和512-bit权重带宽。最大当前层权重块约5.63 KiB，最大3行输入
缓冲约3 KiB。48通道候选更快，但每拍权重带宽升到768 bit，RAM分bank和布线
更难。

因此“8个PE”指8个输出通道部分和，每个PE内部还有18或36条lane。当前实现
顺序为：先以`8/4/9`争取速度；若Vivado的WNS、DSP列布线或BRAM端口不成立，
同一RTL回退到`8/2/9`；最后以LUT、FF、BRAM、DSP、WNS和真实周期形成
Pareto表。

早期没有系统延迟目标时，16/32/48通道只是解析锚点。参考Tan的亚毫秒估计器
和用户要求的速度竞争性后，当前目标改为200 MHz附近计算低于1 ms，因此选择
144/288通道。完整L1闭环测得每次padded scan的总填充/排空开销为14拍；据此
校准后的200 MHz保守估计分别为1.003/0.595 ms。144-DSP点略高于1 ms，仍是
时序/布线回退；事件收满400个所需的传感器时间须与这些计算延迟分开报告。

## 实现状态

上述依赖已经全部实现到Vivado之前：同一个`P_OC/P_IC/P_K=8/4/9`核心覆盖
L1～L8，S40部分和RAM、H1/H2、readout、激活/状态RAM、L3电流缓存及
FS-TM/SL-TM/SL-HYB控制器均已接通。完整RTL对三条路线分别检查270,000、
270,000和159,408个值，均为零失配；周期为119,791、119,791和83,286。
冻结顶层使用288个卷积DSP、16个dense DSP和2个readout DSP，共306个。

稠密基线下一步只剩器件相关闭环：用Vivado对lean/full两个构建做综合与布局
布线，检查200 MHz WNS、实际RAM推断和拥塞。144-DSP结构仍是已分析的资源
回退方向，不是当前已经打包验证的第二个完整顶层。此后实现的L1 add-only、
L2 count-MAC稀疏前端已接入`Sparse-TM`与`Sparse-LM-A`两个完整顶层；两者与
稠密基线均有独立Vivado OOC入口，详见05报告和`code/hardware/vivado/README.md`。

机器结果位于：

- `/data/xuzx/result/ebv-eye/pursuit/fixed_event_window/hardware/channel_profile_20261006/`；
- `/data/xuzx/result/ebv-eye/pursuit/fixed_event_window/hardware/dataflow_design_space_20261006.json`；
- `/data/xuzx/result/ebv-eye/pursuit/fixed_event_window/hardware/synapse_arithmetic_comparison_20261006/`。
- `/data/xuzx/result/ebv-eye/pursuit/fixed_event_window/hardware/rtl_schedule_estimate_l1calibrated_20261006.json`。
- `/data/xuzx/result/ebv-eye/pursuit/fixed_event_window/hardware/rtl_microkernels_open_source_20261006/`。
- `/data/xuzx/result/ebv-eye/pursuit/fixed_event_window/hardware/rtl_core_open_source_20261006/`。
- `/data/xuzx/result/ebv-eye/pursuit/fixed_event_window/hardware/rtl_l1_streaming_golden_20261006/`。
- `/data/xuzx/result/ebv-eye/pursuit/fixed_event_window/hardware/rtl_full_accelerator_pre_vivado_20261006/`。

早期设计空间JSON和L1校准周期模型保留为设计过程证据。L2～L8的输入tile
切换、部分和仲裁、dense及全网控制现已由逐拍RTL回放替换；仍缺Vivado布局
布线结果。
