zen5x5/ebv-eye_snn_hardware/docs/related_work.md

# FPGA、专用芯片与 SNN 眼动追踪性能比较

更新日期：2026-10-18。本项目一行采用seed2021 user10稠密L1～L2无状态的完整实现及输入活动功耗结果；外部工作保留既有原文来源与统计范围。

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

FPGA 是可以重新配置电路的器件；ASIC 是专门制造的芯片。SNN 使用脉冲神经元，ANN 使用常规神经网络运算。事件相机可以配合这两类网络及传统图像算法。SEE 的 SCNN 指稀疏卷积网络；Tan 使用常规卷积网络。

吞吐量表示每秒能完成多少次处理；延迟表示一次输入到对应输出的时间。µJ 是微焦耳，mJ 是毫焦耳；1 mJ = 1,000 µJ。下表分别注明原文数值、算术换算、实测和估算。

## 1. FPGA 实现：速度与能量

| 工作 | 平台、输出 | 处理时间 | 吞吐或更新率 | 功率 | 每次能量 |
|---|---|---:|---:|---:|---:|
| 当前实现 | XCZU3EG；400事件→连续屏幕坐标 | 0.492606 ms，核心 | 约2030次/s，串行换算 | 0.579625 W，实际输入活动估算 | 285.527 µJ，16输入均值 |
| SEE-D 2024 | ZCU102 FPGA＋Arm；眼中心 | 原文 0.70 ms，SCNN 0.59＋GRU/FC 0.11 | 约 1,429/s，由总时间换算 | 原文 3.86 W | 原文 2.29 mJ |
| SEE-C 2024 | 同一论文的较快模型；眼中心 | 原文 0.60 ms，0.49＋0.11 | 约 1,667/s，由总时间换算 | 原文 3.86 W | 原文 1.88 mJ |
| Khaki 2023 | PYNQ-Z1；瞳孔中心、角膜反光点及瞳孔尺寸 | 原文 1.8 ms，含处理器传输 | 原文最高 500 FPS | 原文 247 mW，控制面板数值 | 494 µJ，由功率/500 FPS 换算 |
| Kowalski 2021 | Kintex-7 325T＋PC CPU；瞳孔中心 | 原文 0.6～2.1 ms，含相机读出、传输和 CPU 拟合 | 原文演示 575、1,250、5,400 FPS 三种配置 | 原文未报告电路功率 | 原文未报告 |
| Ando 2012 | Cyclone II 2C70；传统算法定位人眼 | Table 1 总计 118.9 ms，含采集和格式整理 | 原文约 8 FPS | Table 2 为 375.45 mW，Quartus 工具估算 | 本报告不另行换算 |
| Yang 2018 | Kintex-7 上的视线追踪电路原型 | 已核摘要未给输入到输出延迟 | 原文超过 380 Hz | 已核摘要未给 | 已核摘要未给 |
| Yu 2021 | 单 FPGA；人眼特征与视线方向分类 | 原文分类模块识别时间 0.52 µs | 原文 640×480、80 FPS | 已核摘要未给 | 已核摘要未给 |
| Wu、Han 2024 | Zynq-7035＋Arm；结合人脸、头部姿态和眼图估计视线 | 已核摘要未给系统延迟 | 原文 32 FPS | 原文平均 6.4 W，供电测量范围待全文核对 | 本报告不另行换算 |

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

Yu 的 0.52 µs 覆盖视线方向分类模块，其相机输入为 80 FPS。两项分别记录。Kowalski 的采集与处理可以重叠，表中的延迟和帧率分别来自各配置的实际报告。

## 2. FPGA 实现：资源和时钟

LUT 是实现逻辑运算的小单元；FF 是保存一位数据的寄存器；DSP 是专用算术单元；BRAM 是片上块存储。它们共同描述 FPGA 为这套电路占用了多少器件资源。

| 工作 | 时钟 | LUT | FF | DSP/计算单元 | 片上存储 |
|---|---:|---:|---:|---:|---|
| 当前实现 | 完整顶层时序通过160 MHz | 29,546 | 17,113 | 308 DSP | 107 RAMB36＋30 RAMB18，合计122块36Kb等效 |
| SEE-D | 该文未列时钟 | 约 130K | 约 90K | 1,606 DSP | BRAM 1,092，原文计数单位 |
| SEE-C | 该文未列时钟 | 约 135K | 约 94K | 1,880 DSP | BRAM 1,001，原文计数单位 |
| Khaki | 100 MHz | 9,584 | 11,750 | 11 DSP | 40 BRAM；Table 1 的器件总量为 140 |
| Kowalski | 处理 100 MHz，像素重排 110 MHz | 未列 | 未列 | 未列 | FPGA DRAM 和局部缓冲，未列总量 |
| Ando | 27 MHz | 原文合计 8,878 logic cells，保留该计数 | 未单列 | 28 个乘法器 | 片上 SRAM 53,184 bit；另有板上 SDRAM/SSRAM |
| Yang | 200 MHz | 已核摘要未给 | 已核摘要未给 | 已核摘要称电路未调用 DSP | 已核摘要称未使用外部存储 |
| Yu | 100 MHz | 已核摘要未给 | 已核摘要未给 | 已核摘要未给 | 已核摘要未给 |
| Wu、Han | 已核摘要未给 | 已核摘要未给 | 已核摘要未给 | 已核摘要未给 | 已核摘要未给 |

BRAM 的比较保留论文使用的计数方式。SEE 表中未说明 18/36 Kb 单位，当前实现显式给出两类物理块数量。Ando 的 logic cells 是另一代器件的资源计数，本表按原名称保留。

## 3. Tan：已制造并测试的专用芯片

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

数值取芯片测试章节的 Fig.13/14 和 Table III。处理范围包含事件区域选择与网络推理。测试系统使用 ZCU102 连接芯片，视线计算由定制芯片完成。

## 4. SNN 眼动追踪：8 篇独立工作

以下按网络实际输出、运行平台和验证阶段列出。Groenen、Paredes-Valles、Hueber 三项按本次核读的 2025 年 arXiv v1 记录。

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

NeuroEye 摘要明确给出跨层脉冲流水处理，适合作为当前设计的重点结构对照。其完整输入规模、网络精度、面积和逐层延迟仍需取得全文核读；本报告先收录已经核对的摘要数字。

本轮核对到的 SNN 硬件主要采用专用脉冲芯片或定制芯片设计。SNN、眼动任务、FPGA 加速电路三者同时满足的已发表实现，本报告尚未核实到可列入的独立外部工作。

## 5. 精度与处理对象

| 工作 | 输入与评价对象 | 精度 |
|---|---|---|
| 当前user10模型 | 400事件，2×96×128，Pursuit单用户test | 浮点0.490071°，定点0.506021° |
| 当前正式多用户结果 | Pursuit/Saccade 各 24 用户，逐用户训练 | 定点等权均值 0.825481°/1.326037° |
| Tan | 500 事件窗、每 200 新事件触发；2×120×220；EBV-Eye | 正文跨用户平均 1.15°，最佳 0.91° |
| SEE-D / SEE-C | AIS2024 事件眼中心定位 | 平均像素距离 3.71 / 4.05 px |
| Khaki | 176×120 灰度眼图；与软件结果对照 | 横/纵最大偏差 ±1 px |
| Kowalski | 灰度瞳孔图，三种 ROI/相机配置 | 模型瞳孔中心精密度 0.5～1.5 µm |
| Yang | 面向 VR 的视线追踪原型 | 摘要报告误差不超过 1.5° |
| Yu | 视线方向分类 | 摘要报告平均识别率 92% |
| Retina | Ini-30；64×64 输入；validation | 平均瞳孔位置误差 3.24 px |
| GazeSCRNN | EV-Eye 视线方向预测 | 原文平均角误差 6.034°；训练和评价协议见原文 |
| Hueber | 3ET+ 瞳孔位置预测 | 原文平均像素距离约 3.7～4.1 px |

角度误差、像素定位误差、方向分类准确率和模型瞳孔精密度分别衡量不同输出的质量；表中保留原评价量。user10的0.506021°属于当前单用户定点结果，多用户结果单独列出。GazeSCRNN、Tan 和当前项目各自的输入、切分和用户汇总方式沿用各自实验定义。

## 6. 当前设计的位置与优先对照

当前稠密核心0.493 ms、约2030样本/秒，完整FPGA时序检查通过。
L1～L2无状态相对本项目全状态基线节省25.15%核心时间、28.45%BRAM和29.02%推理总能量。
主设计约0.580 W、285.5 µJ/样本为实际权重和输入活动驱动的工具估算。
Tan为专用芯片实测，SEE为较大FPGA与Arm系统，NeuroEye为40nm布局布线后评估，
各项统计范围见表格。当前验证阶段和原始数据见[结果报告](results.md)。

## 7. 性能数字的逐项核对

### 当前实现

78,817拍 / 160,000,000拍每秒 = 0.49260625 ms。

16输入总功率均值0.579625 W × 0.49260625 ms = 285.52689765625 µJ。

功耗来自布线后功能电路的实际输入活动，覆盖核心推理窗口，
固定25°C结温、典型工艺和标称电压。输入装载及板卡外设单列。

### SEE、Khaki 与 Tan

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

### Retina：测量范围与能量单位

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

同表能量列标成 mJ，数值为 16.10/38.40；功率乘延迟的单位换算为：

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

原表能量单位与同表功率、延迟相差 1,000 倍。本报告写出原始数值与算术核对结果，能量比较使用时保留其隔离输入测量条件。

### NeuroEye：吞吐量与单次延迟

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

### Sui：分别记录算法运行速度和能耗估算

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

本报告保留这些分别报告的量及其运行条件；0.023 J 对应一次分割网络计算，102.2 mW 对应整套模式切换系统的估算。

### E-SpikePT 与 Hueber：计算依据

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

Hueber 的效率预测使用 SENeCA 能耗模型；约 3 ms 延迟按三个连续脉冲层的流水处理估计。原文 §IV-B、结论均将其标为预测，实际部署列为后续工作。

## 8. 原始来源与核读范围

### 已保留的硬件对照

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

### 新增 FPGA 对照

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

### 新增 SNN 对照

- Bonazzi et al., *Retina: Low-Power Eye Tracking with Event Camera and Spiking Hardware*, CVPR Workshops 2024。[正式全文](https://openaccess.thecvf.com/content/CVPR2024W/AI4Streaming/papers/Bonazzi_Retina__Low-Power_Eye_Tracking_with_Event_Camera_and_Spiking_CVPRW_2024_paper.pdf)。核读 §5.2.4、Table 9/10，包括测量电源分项和能量单位。
- Jiang et al., *Eye Tracking Based on Event Camera and Spiking Neural Network*, Electronics 13(14), 2879, 2024。[正式全文](https://doi.org/10.3390/electronics13142879)。核对 §4.1 的 RTX 3090 实验平台及结论中的后续硬件部署。
- Groenen et al., *GazeSCRNN: Event-based Near-eye Gaze Tracking Using a Spiking Neural Network*, arXiv:2503.16012v1, 2025。[全文](https://arxiv.org/html/2503.16012v1)。核对摘要的 6.034°及讨论中的后续延迟、能耗硬件评价。
- Zheng et al., *NeuroEye: A 54.59mW, 12200FPS Event-Driven Near-Sensor Eye-Tracking Processor with Pipelined Spatial-Temporal Spike-Streaming*, ISCAS 2025。[IEEE 摘要](https://doi.org/10.1109/ISCAS56072.2025.11043272)。核对摘要所列 40 nm、54.59 mW、12,200 FPS、4.47 µJ/次及布局布线后评估阶段；全文待取得。
- Paredes-Valles et al., *Realizing Fully-Integrated, Low-Power, Event-Based Pupil Tracking with Neuromorphic Hardware*, arXiv:2511.20175v1, 2025。[全文](https://arxiv.org/html/2511.20175v1)。核读 §2.1、§4.3、Fig.6 及结论，区分 Speck2f 和微控制器功率。
- Hueber et al., *Neuromorphic Eye Tracking for Low-Latency Pupil Detection*, arXiv:2512.09969v1, 2025。[全文](https://arxiv.org/html/2512.09969v1)。核读 Table III、§IV-B 与结论中的 SENeCA 模型和延迟预测。
- Sui et al., *Event-based Low-power Spiking Gaze Estimation*, Engineering Applications of Artificial Intelligence 165, 113359, 2026。[出版社入口](https://doi.org/10.1016/j.engappai.2025.113359)。核读本地正式全文 p14～15 的速度平台、§4.5 与 Table 4/5；原文按本节出版社链接查阅。
- Kang et al., *E-SpikePT: Energy-efficient Event-based Eye Tracking with Spiking Neural Networks and Knowledge Distillation*, Neurocomputing 681, 133433, 2026。[出版社入口](https://doi.org/10.1016/j.neucom.2026.133433)。核读本地正式全文 §4.3 与 p8，核对运算成本、49 µJ 和实际硬件部署状态。

### 本项目机器证据

- [原始总表](../results/summary.json)、[资源与时序报告](../results/implementation/l1_l2_stateless/reports/)、[64份功耗证据](../results/power/)、[四版本主报告](results.md)。
