zen5x5/ebv-eye_snn_hardware/docs/model/02_snn_fixed_alpha_comparison.md

# Pursuit SNN固定alpha三seed对照

## 1. 研究问题

本文在[当前无尾窗数据协议与ANN结果](01_all_physical_source_event_recombination_baseline.md)上，只改变SNN的固定膜电位保留系数alpha，比较`0.25`、`0.5`和`0.75`。每档alpha均使用seed2021、2022、2023从头训练200轮。

这里的alpha越小，每个bin之间保留的旧膜电位越少；alpha越大，跨bin积累越强。本文不改变时间步、输入、网络宽度、阈值学习方式或训练预算。

## 2. 固定设置

### 2.1 数据与训练

- 数据：user15 eye0 pursuit，物理train/validation/test为`2961/426/426`；
- 在线重组：全部2961个物理train窗可作source/partner，每轮增加2948个合成图；
- 输入：同一完整400事件计数图重复输入T=2；
- 每轮5909个训练输入，batch16且`drop_last=True`，更新369次；
- 训练200轮，Adam初始学习率0.001，无早停；
- ReduceLROnPlateau按validation样本平均角误差调度，按同一指标保存最佳checkpoint。

### 2.2 模型

- 八层卷积通道：`2→8→16→24→32→40→40→40→40`；
- L1～L5：`Conv3×3(bias=False)→BN→MaxPool2×2→LIF`；
- L6～L8：`Conv3×3(bias=False)→BN→LIF`；
- 脉冲隐藏头：`480→60→12`，两个Linear带bias并后接LIF；
- 连续读出：12维末层脉冲沿T求平均，再做`Linear(12,2,bias=False)`；
- MultiSpike、PeriodicExponential、减阈值复位、`min_v_mem=-1`；
- 每个输出通道学习一个初值为1的正阈值，全层保留跨bin膜状态，不施加bias约束；
- 可训练参数96,792，跨bin膜状态45,000个/样本。

三组实验唯一主动改变的模型变量是固定alpha。

## 3. 三seed汇总

下表为均值±样本标准差。每个性能单元格依次给出train、validation和test；train只在2961个物理train图上评价。

| 指标 | alpha=0.25 | alpha=0.5 | alpha=0.75 |
|---|---:|---:|---:|
| 像素误差（px） | train: 8.18±0.48<br>validation: 15.31±0.15<br>test: 15.66±0.74 | train: 7.84±0.45<br>validation: 15.48±0.77<br>test: 15.49±0.70 | train: 7.22±0.22<br>validation: 14.83±0.30<br>test: 15.01±0.55 |
| 角误差（°） | train: 0.433±0.027<br>validation: 0.779±0.018<br>test: 0.801±0.039 | train: 0.413±0.022<br>validation: 0.779±0.033<br>test: 0.792±0.033 | train: 0.379±0.012<br>validation: 0.740±0.012<br>test: 0.762±0.034 |

validation活动统计来自每个seed的最佳checkpoint：

| 指标 | alpha=0.25 | alpha=0.5 | alpha=0.75 |
|---|---:|---:|---:|
| SynOps/样本 | 7.691±0.552M | 7.690±0.521M | 8.125±0.524M |
| 相对正式ANN稠密MAC | 74.0% | 74.0% | 78.2% |
| 相对Compact90K ANN稠密MAC | 75.2% | 75.2% | 79.4% |
| 隐藏脉冲/样本 | 36.96±2.50k | 37.66±2.25k | 40.53±3.25k |
| bias-only脉冲/样本 | 22.33±3.21k | 24.80±1.06k | 28.27±4.71k |

“隐藏脉冲”是L1～L8、H1和H2的脉冲计数之和；SynOps是这些脉冲按下一层扇出估算的稀疏突触操作数。两个ANN参照的稠密计算量为：

| ANN参照 | MAC/样本 | 相对正式ANN | 参数量 |
|---|---:|---:|---:|
| 正式ANN：`2→8→16→24→32→40→40→40→40`，`480→60→12→2` | 10.391M | 100% | 96,480 |
| Compact90K：`2→8→16→24→32→36→36→36→36`，`432→48→12→2` | 10.229M | 98.4% | 78,868 |

Compact90K比正式ANN少17,612个参数（18.25%），但只少0.162M MAC/样本（1.56%）。原因是两者计算最重的L1～L4完全相同，Compact只缩窄低分辨率的L5～L8和回归头。SNN本身仍采用正式ANN的40通道骨架；这里相对Compact90K的百分比只是把当前SNN活动量与较小ANN的稠密计算量放在同一算术口径下比较，并不是同构模型对照。

上述ANN数字只计Conv和Linear的乘加，SNN数字只计按实际脉冲及扇出估算的突触累加；两者都未在这张表中加入BN、激活、池化、膜状态读写、神经元更新和事件路由。因此这些比例是算术操作数量对照，不等于实测延迟或能耗。SNN连续`12→2`读出另有24个MAC，对百分比没有可见影响。

## 4. 结果解读

- 当前三seed结果中，alpha=0.75的validation/test角误差最低，为`0.740±0.012/0.762±0.034°`。
- 相对alpha=0.5，alpha=0.75的test平均改善0.030°，validation SynOps增加0.435M/样本，约增加5.7%。
- alpha=0.25与0.5的validation均值几乎相同；test只相差0.009°，小于两组各自的seed标准差。两者的平均SynOps也只相差0.001M/样本，不能据此排出稳定优劣。
- 在当前T=2重复输入、可学习阈值和完整BN模型下，较大的alpha=0.75给出了更好的精度端点，同时也学出了更高的发放活动。该结论只适用于本数据、模型和训练协议，不单独证明alpha对其他时间组织具有同样影响。

因此，若后续优先选择当前精度端点，仍使用alpha=0.75；若硬件映射确认约5.7%的SynOps差异重要，再把alpha=0.5作为效率对照，而不是仅凭软件活动估算提前替换基线。

## 5. 各层bias-only脉冲

### 5.1 统计定义

对每个最佳checkpoint，把该层正常突触输入完全置零，只向神经元连续两个bin施加推理时折叠得到的BN bias或Linear bias。由此产生的脉冲记为`bias-only`脉冲；卷积层的单位置结果再乘该层空间位置数。下表均为三seed均值±样本标准差。

“全模型份额”是该层bias-only脉冲占L1～L8、H1、H2的bias-only脉冲总和。“相对真实层脉冲”用该层bias-only脉冲除以真实validation输入下该层平均总脉冲。后一比值可以超过100%：真实卷积输入包含负贡献，可能抵消bias，因此它不是从真实前向中逐个脉冲追溯得到的因果比例。

### 5.2 alpha=0.25

| 层 | bias-only脉冲/样本 | 全模型份额 | 相对真实层脉冲 |
|---|---:|---:|---:|
| L1 | 0±0 | 0.0±0.0% | 0.0±0.0% |
| L2 | 6,912±2,032 | 30.5±5.6% | 49.9±12.3% |
| L3 | 10,112±1,092 | 45.8±6.7% | 146.9±23.5% |
| L4 | 2,112±710 | 9.3±2.1% | 70.1±19.1% |
| L5 | 256±14 | 1.2±0.1% | 23.4±0.6% |
| L6 | 980±242 | 4.4±0.8% | 171.3±45.0% |
| L7 | 968±98 | 4.4±0.6% | 144.1±10.2% |
| L8 | 992±78 | 4.5±1.0% | 295.6±7.5% |
| H1 | 0±0 | 0.0±0.0% | 0.0±0.0% |
| H2 | 0±0 | 0.0±0.0% | 0.0±0.0% |
| 合计 | 22,332±3,214 | 100% | 60.2±4.8% |

### 5.3 alpha=0.5

| 层 | bias-only脉冲/样本 | 全模型份额 | 相对真实层脉冲 |
|---|---:|---:|---:|
| L1 | 1,024±1,774 | 4.2±7.3% | 8.6±14.8% |
| L2 | 7,168±1,599 | 28.8±5.7% | 52.2±7.8% |
| L3 | 9,664±443 | 39.0±0.1% | 144.4±9.5% |
| L4 | 3,360±375 | 13.5±1.3% | 114.9±10.1% |
| L5 | 336±105 | 1.3±0.4% | 31.5±8.0% |
| L6 | 1,108±129 | 4.5±0.4% | 211.7±11.3% |
| L7 | 1,012±62 | 4.1±0.1% | 157.6±4.6% |
| L8 | 1,132±91 | 4.6±0.5% | 280.3±23.6% |
| H1 | 0±0 | 0.0±0.0% | 0.0±0.0% |
| H2 | 0±0 | 0.0±0.0% | 0.0±0.0% |
| 合计 | 24,804±1,061 | 100% | 65.9±1.2% |

### 5.4 alpha=0.75

| 层 | bias-only脉冲/样本 | 全模型份额 | 相对真实层脉冲 |
|---|---:|---:|---:|
| L1 | 2,048±1,774 | 6.6±5.8% | 13.9±12.0% |
| L2 | 9,216±1,330 | 32.7±1.3% | 63.4±9.0% |
| L3 | 9,984±1,832 | 35.3±1.3% | 143.6±20.1% |
| L4 | 3,168±427 | 11.5±3.3% | 113.5±10.8% |
| L5 | 412±48 | 1.5±0.2% | 40.7±5.7% |
| L6 | 1,008±166 | 3.6±0.1% | 201.2±20.2% |
| L7 | 1,160±30 | 4.2±0.8% | 175.4±12.6% |
| L8 | 1,272±55 | 4.6±1.0% | 276.7±6.7% |
| H1 | 0±0 | 0.0±0.0% | 0.0±0.0% |
| H2 | 0±0 | 0.0±0.0% | 0.0±0.0% |
| 合计 | 28,268±4,706 | 100% | 69.4±6.3% |

三档alpha中，L2＋L3合计占全模型bias-only脉冲约76.3%、67.8%和68.0%，是绝对数量的主要来源。L6～L8虽然“相对真实层脉冲”比值很高，但空间图只有`40×3×4`，所以bias-only绝对量仍远小于L2/L3。H1/H2的可学习bias在九个checkpoint上均未独立推动发放。

## 6. 逐seed性能

### 6.1 像素误差

| seed | alpha=0.25 | alpha=0.5 | alpha=0.75 |
|---|---:|---:|---:|
| 2021 | train: 8.60<br>validation: 15.48<br>test: 16.40 | train: 8.34<br>validation: 14.64<br>test: 16.26 | train: 7.47<br>validation: 14.68<br>test: 15.64 |
| 2022 | train: 7.66<br>validation: 15.19<br>test: 14.93 | train: 7.48<br>validation: 16.16<br>test: 14.92 | train: 7.10<br>validation: 14.63<br>test: 14.79 |
| 2023 | train: 8.28<br>validation: 15.26<br>test: 15.64 | train: 7.69<br>validation: 15.64<br>test: 15.28 | train: 7.09<br>validation: 15.17<br>test: 14.60 |

### 6.2 角误差

| seed | alpha=0.25 | alpha=0.5 | alpha=0.75 |
|---|---:|---:|---:|
| 2021 | train: 0.459<br>validation: 0.799<br>test: 0.841 | train: 0.438<br>validation: 0.743<br>test: 0.828 | train: 0.392<br>validation: 0.739<br>test: 0.801 |
| 2022 | train: 0.405<br>validation: 0.767<br>test: 0.764 | train: 0.396<br>validation: 0.808<br>test: 0.762 | train: 0.375<br>validation: 0.729<br>test: 0.745 |
| 2023 | train: 0.435<br>validation: 0.771<br>test: 0.798 | train: 0.406<br>validation: 0.787<br>test: 0.785 | train: 0.370<br>validation: 0.753<br>test: 0.740 |

### 6.3 轮次、活动与墙钟

| alpha | seed | 最佳轮次 | SynOps/样本 | 隐藏脉冲/样本 | bias-only脉冲/样本 | 训练墙钟 |
|---|---:|---:|---:|---:|---:|---:|
| 0.25 | 2021 | 188 | 7.055M | 34.08k | 18.68k | 128.81 min |
| 0.25 | 2022 | 173 | 8.048M | 38.62k | 24.74k | 62.98 min |
| 0.25 | 2023 | 143 | 7.970M | 38.19k | 23.57k | 89.08 min |
| 0.5 | 2021 | 178 | 7.281M | 36.19k | 24.23k | 62.09 min |
| 0.5 | 2022 | 197 | 8.276M | 40.25k | 26.03k | 121.74 min |
| 0.5 | 2023 | 189 | 7.512M | 36.55k | 24.16k | 79.44 min |
| 0.75 | 2021 | 182 | 7.544M | 36.83k | 22.97k | 49.15 min |
| 0.75 | 2022 | 198 | 8.269M | 41.87k | 29.88k | 64.97 min |
| 0.75 | 2023 | 176 | 8.562M | 42.90k | 31.96k | 67.63 min |

墙钟受共享GPU负载影响，只作执行审计，不用于比较alpha效率。

## 7. 正式产物

- alpha=0.25：`$EBV_EYE_RESULT_ROOT/pursuit/fixed_event_window/snn/user15/eye0/no_tail_all_physical_source_recombination_t2_alpha0p25_epoch200/`
- alpha=0.5：`$EBV_EYE_RESULT_ROOT/pursuit/fixed_event_window/snn/user15/eye0/no_tail_all_physical_source_recombination_t2_alpha0p5_epoch200/`
- alpha=0.75：`$EBV_EYE_RESULT_ROOT/pursuit/fixed_event_window/snn/user15/eye0/no_tail_all_physical_source_recombination_t2_alpha0p75_epoch200/`

每个目录均含seed2021/2022/2023的`configuration.json`、200轮`training_history.json`、最佳checkpoint、`summary.json`及`analysis/activity_validation.json`。
