zen5x5/ebv-eye_snn_hardware/evidence/current/vivado/run_summary.txt

variant=sparse_lm_a
top=pursuit_sparse_layer_major_accelerator_top
part=xczu3eg-sfvc784-2-e
target_clock_period_ns=5.000
worst_setup_slack_ns=-1.109
worst_hold_slack_ns=0.040
unconstrained_timing_issue_count=0
critical_warning_count=0
critical_warnings_report=/tmp/ebv-l2-lutram.LOkj5z/full_route/reports/post_route_critical_warnings.rpt
source_hashes_verified_unchanged=1
timing_met=0
power_scope=vectorless_estimate_only_not_acceptance_evidence
