zen5x5/ebv-eye_snn_hardware/docs/hardware/figures/ebv_eye_event_driven_layer_adjacent_architecture.png

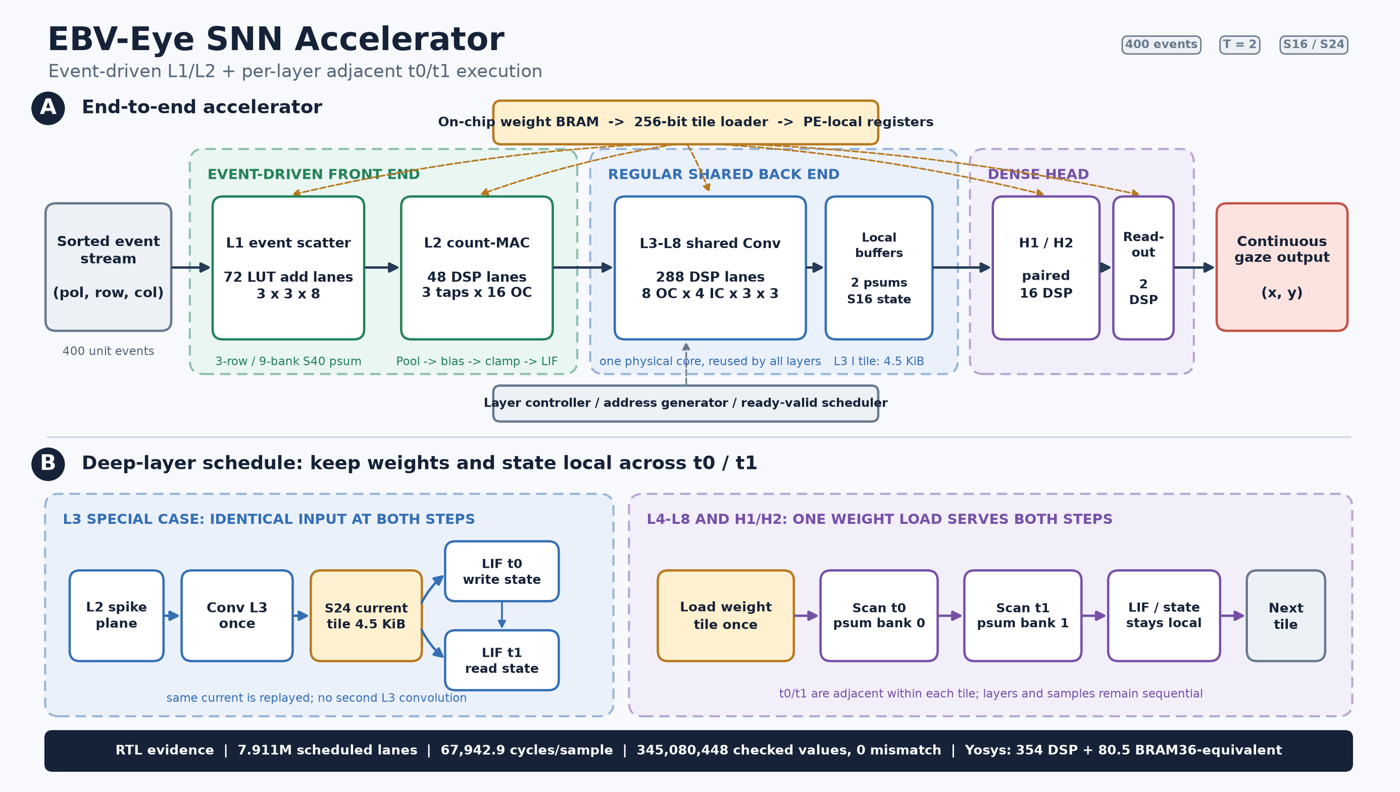
docs/hardware/figures/ebv_eye_event_driven_layer_adjacent_architecture.png
