zen5x5/ebv-eye_snn_hardware/docs/hardware/figures/ebv_eye_final_pe_bram_dataflow.png

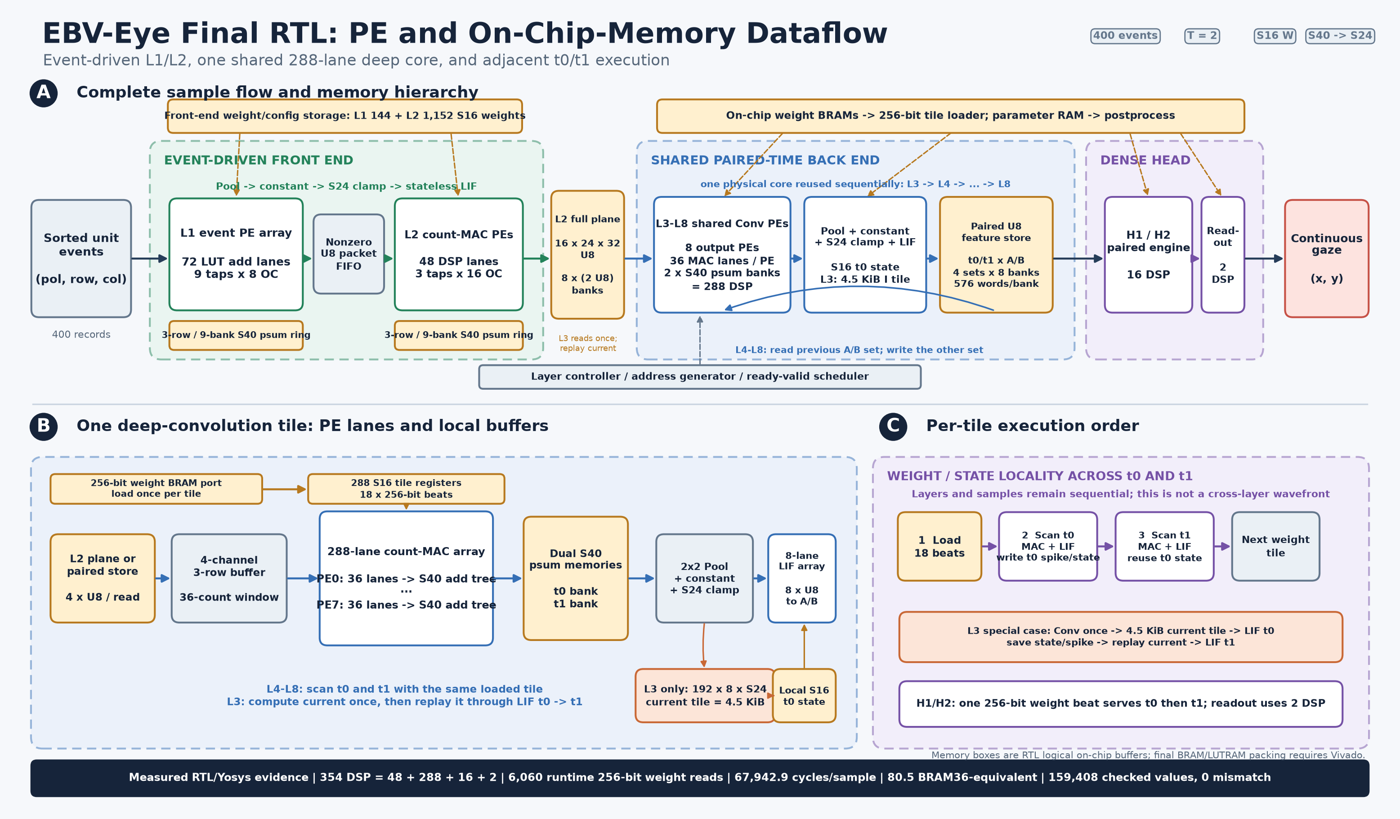
docs/hardware/figures/ebv_eye_final_pe_bram_dataflow.png
