zen5x5/ebv-eye_snn_hardware/VALIDATION.md

# 当前仓库验证

## 2026-10-17：导师阅读入口重排

README 按“网络结构→软件与定点精度→FPGA 性能与资源占比→其他工作对比→硬件数据通路”组织。新增网络结构 SVG，复现命令、目录及补充文献使用可展开区域。

| 检查 | 结果 |
|---|---|
| 精度表 | 当前 user17 与 Pursuit/Saccade 两项多用户结果逐项对照量化 JSON，浮点、定点及差值均通过 |
| 资源占比 | LUT 87.38%、FF 17.60%、DSP 85.56%、BRAM36 等效 69.91%；使用数与容量对照 Vivado 原始报告 |
| 外部工作 | 16 篇均保留：首页直接展示 7 篇，其余 9 篇在可展开表中；SEE-C/D 为同一篇 |
| 网络图 | SVG XML 解析通过，渲染为 1920×645 图片后目视检查通过 |
| Markdown 本地链接 | 55 个目标全部存在；3 组可展开标签配对正确 |
| 资产与代码 | 116 条资产校验通过；代码、模型及硬件证据保持原样 |
| 文本格式与清单 | git diff --check、MANIFEST.sha256 逐文件校验通过 |

本次更新为首页文档与网络图整理，沿用以下已有的仿真和器件实现结果。

## 2026-10-17：文献比较更新

本次修改性能对比报告、阅读索引和仓库说明，代码、模型、权重、标准向量及既有硬件证据保持原样。

| 检查 | 结果 |
|---|---|
| 文献收录与去重 | 7 篇 FPGA 实现或原型、8 篇 SNN 研究及 Tan，共 16 篇；SEE-C/D 计为同一论文 |
| 原文依据 | 每篇标明来源及全文、摘要的实际核读范围 |
| Retina 能量表 | 目视正式 PDF p8 的 Table 9；记录原表 mJ 单位及功率×延迟得到的 µJ 换算 |
| Sui 和 Paredes-Valles 功率范围 | 分别标明算法速度测量平台、能耗估算条件，以及 Speck2f/微控制器功率 |
| 对比表算术 | 当前周期、能量、94/267 倍数、Retina 两种窗和 Khaki 的能量换算检查通过 |
| Markdown 本地链接 | 44 个目标全部存在 |
| 可移植资产校验 | 116 条资产校验通过 |
| 代码和硬件证据 | 与本次更新前提交比较无改动 |
| 文本格式与仓库清单 | git diff --check 及 MANIFEST.sha256 逐文件校验通过 |

本次未重新运行 XSim 或 Vivado 综合、布局布线；下节保留 2026-10-16 的实际硬件验证记录。

## 2026-10-16：硬件交付验证

日期：2026-10-16。以下检查从本次克隆和更新后的仓库执行。

| 检查 | 结果 |
|---|---|
| 可移植资产校验 | 116 条资产校验通过 |
| 当前整网 XSim 回放 | 159,408 个值零失配，104,005 拍 |
| 输入与中间包 | 400 个事件，L1/L2 各传递 3,315 个非零包 |
| 仿真阶段计数 | 前端 51,305；共享卷积 48,609；全连接 4,074 拍 |
| 当前 13 个综合 RTL 源文件与已布线快照比较 | SHA-256 一致 |
| Python 语法 | 49 个文件通过 |
| Shell 语法 | 两个 Vivado 入口通过 bash -n |
| Tcl 脚本接口 | 6.250/5.000 ns 的源文件、时钟设置和运行记录检查通过 |
| Markdown 本地文件链接 | 全部有效 |
| 当前架构 SVG | XML 解析通过 |
| 仓库清单 | MANIFEST.sha256 逐文件检查通过 |

XSim 回放使用随仓库提供的 user17/seed2022 真实输入、权重和逐层标准数值；工具为 Vivado 2025.2.1 的 xvlog、xelab、xsim。复现命令：

```bash
source /opt/amd/2025.2.1/Vivado/settings64.sh
python -B scripts/replay_current.py --output-dir build/replay
```

[导出后重新回放的记录](evidence/current/rtl_replay/export_report.json)、[仿真日志](evidence/current/rtl_replay/simulation.log)与[此前逐状态计数](evidence/current/rtl_replay/report.json)分别保存。

本次整理使用此前已经完成的 Vivado 布线报告，检查当前 RTL 与其源码快照一致。本次新增验证覆盖功能回放和运行入口；完整布局布线留待需要重建 checkpoint 时执行。

原 2026-10-13 user15 的回放和三路线数据保存在 evidence/rtl_three_route/，对应完整源代码和向量可从提交 3fef30e 取得。
