zen5x5/ebv-eye_snn_hardware/docs/results.md

# 分别训练的模型：状态深度与硬件成本

本轮使用全有状态、仅L1无状态、L1～L2无状态、L1～L3无状态四组各自训练得到的权重，
按各自的膜电位规则执行。旧稀疏方案的设计和指标见[稀疏对照](sparse_comparison.md)。

## L1～L4无状态扩展：时间和BRAM

2026-10-19新增第五档，仍为Pursuit user10、eye0、seed2021、T2重复完整400事件，
使用独立训练的L1～L4无状态最佳checkpoint（epoch198）。L1～L4完整输出各算一次，
L5卷积/池化电流算一次、神经元更新两次，L6～H2按原来的逐层相邻两步执行。
现有0～3档的控制方式和缓存尺寸不变。

| 无状态层 | 核心拍数 | 160MHz核心时间 | BRAM36等效块 |
| --- | ---: | ---: | ---: |
| 无 | 105,305 | 0.658156 ms | 170.5 |
| L1 | 90,525 | 0.565781 ms | 132.5 |
| L1～L2 | 78,817 | 0.492606 ms | 122 |
| L1～L3 | 72,101 | 0.450631 ms | 120 |
| L1～L4 | 68,293 | 0.426831 ms | 120 |

新增版本16个validation输入（索引0～15）完整RTL回放共核对2,255,616个中间值及32个坐标整数，
失配0；独立int64参考另核对4,320,032值，失配0。核心拍数每样本相同。
综合和布局布线均为105个RAMB36＋30个RAMB18，即120块36Kb等效BRAM；
布线后LUT29,659、FF17,112、DSP308。160MHz建立/保持/脉宽余量为+0.091/+0.011/+2.583ns，
12项时钟与约束检查均为0异常，全部可布线线网完成布线。

L1～L4比L1～L3减少3,808拍（5.28%），BRAM不变。膜、电流和第二步特征缓存缩小后，
仍落在同样数量的BRAM物理块中。模型保留的跨步状态为1,992个；
完整1194个test输入的浮点/定点角误差为0.511031°/0.502631°，用于本次硬件模型留档。
初次扩展仅统计第五档时间与存储；随后补齐的默认活动功耗见下节。
未改论文或运行训练。

随后在carbonite CPU补齐L1～L4无状态的全部24用户定点测试：user4～27、eye0、seed2021，
共25,716个完整test输入。先计算各用户的平均误差，再对24人等权平均，
浮点/16位定点角误差为0.8341314497331875°/0.8327973161956191°，
对应像素误差16.310984822153017/16.285174896721298px。
浮点继续使用原训练报告；定点使用与前四档相同的数值规则，24个模型均在CPU完整重算。
每个模型先核对一个真实输入的61个独立整数参考数组，随后保存全部测试预测；
逐样本误差、用户均值、模型/测试输入校验值均已独立复核通过。
user10的全部1194个预测坐标与既有结果逐值相同。
[第五档24用户完整结果](../results/quantization/l1_l4/results.json)、
[独立核验](../results/quantization/l1_l4/verification.json)。

[五档机器表](../results/latency_bram.json)、[CSV](../results/latency_bram.csv)、
[第五档实现证据](../results/implementation/l1_l2_l3_l4_stateless/summary.json)、
[第五档RTL回放](../results/rtl/l1_l2_l3_l4_stateless/report.json)。
以下四档功耗及历史配对精度表保持原始结果。

## 五档默认活动功耗估算

2026-10-19直接打开五份已有布线检查点，恢复Vivado默认活动，完成五档分析。
两个Vivado进程并行，计算总耗时183.224秒，无需重新综合、布线或运行样本仿真。
统一160 MHz、结温25°C、典型工艺、标称电压；默认普通输入高电平概率0.5，
每周期翻转率12.5%，复位按工具默认保持无效。没有导入SAIF，也未手动指定内部活动。

| 无状态层 | Pursuit总功率估算 | Saccade总功率估算 | 动态功率 | 器件静态功率 | 估算功率×核心时间 |
| --- | ---: | ---: | ---: | ---: | ---: |
| 无 | 0.733 W | 0.733 W | 0.511 W | 0.221 W | 482.429 µJ |
| L1 | 0.595 W | 0.595 W | 0.374 W | 0.221 W | 336.640 µJ |
| L1～L2 | 0.602 W | 0.602 W | 0.381 W | 0.221 W | 296.549 µJ |
| L1～L3 | 0.604 W | 0.604 W | 0.383 W | 0.221 W | 272.181 µJ |
| L1～L4 | 0.691 W | 0.691 W | 0.470 W | 0.221 W | 294.940 µJ |

同一深度的两任务使用同一份可运行时加载权重的电路。此次分析没有任务输入活动，
因此两任务共用五份功耗报告；这里没有分别运行Pursuit和Saccade样本。
功率覆盖整个已实现电路及其评估接口，板卡外围不计入。最后一列仅将默认估算功率乘以
已有核心时间，不含输入加载时长，也未采用逐样本活动；前四档的真实输入活动能量在后文另表保留。
原始功率保留Vivado报告的0.001 W分辨率，分项四舍五入后与总值可相差0.001 W。

五份报告的工具可信度均为Low。报告明确提示：默认活动传播将部分内部复位/控制信号
估成长期处于复位或不使能状态。这组结果用于统一默认设置的对照；分析任务实际运行能量时，
继续采用原来16个真实输入记录的活动结果。L1～L4此次得到的0.691 W保留其默认估算含义。

独立核验已通过：五份输入检查点SHA-256保持不变；默认输入活动、160 MHz时钟、
25°C结温和无SAIF均核对；文本/XML功率及CSV/JSON汇总一致。原64份输入活动功耗保留原样。
[五档汇总](../results/power_vectorless/summary.json)、[CSV](../results/power_vectorless/summary.csv)、
[核验结果](../results/power_vectorless/verification.json)和各档原始报告随仓库保存。

## Pursuit与Saccade的核心时间、BRAM一致性

本节对应论文Table II的连续xy输出网络。同一无状态配置下，两任务的网络尺寸、
两步重复输入、定点位宽、计算阵列及存储布局完全相同；权重与逐通道常量经总线在运行时加载，
综合不读取某个任务的权重文件。因而可使用同一份布线检查点，BRAM数量完全相同。
固定扫描顺序的循环次数由尺寸和状态深度决定，脉冲值不改变循环次数，所以核心时间也完全相同。

已检查四档×两任务×24用户共192份训练配置；另用Saccade user10各自训练的四份权重和
各16个真实validation输入，完成64次RTL回放，累计12,340,224个中间值及128个坐标整数零失配。
每层拍数、膜状态读写组数和计算发射组数逐项与既有Pursuit记录一致，四档核心拍数分别为
105,305、90,525、78,817、72,101。不同任务的实际权重数值已确认不同，张量形状和硬件镜像布局相同。

Saccade旧连续输出头的L1～L4分支现已完成24用户训练，浮点test等权角误差为1.350088°。
随后完成同一组模型的16位定点测试：24用户共28,389个完整test输入，
等权平均角误差1.342359105399257°，对应像素误差26.44682172841815px；
原训练浮点为1.3500876128673553°、26.59480881690979px。
每份模型先核对61个独立整数参考数组，全部测试预测、误差、均值及原模型/缓存哈希均独立复核通过。
[Saccade第五档完整结果](../results/quantization/saccade_l1_l4/results.json)、
[独立核验](../results/quantization/saccade_l1_l4/verification.json)随模型、输入、参数和预测共同保存。
该分支采用与Pursuit第五档相同的网络尺寸、位宽及状态深度，使用同一深度4电路。
上述192份配置和64次Saccade RTL回放的原始记录覆盖前四档。
新增网格脉冲输出头仍单独评价。
[192配置/64回放核验](../results/task_equivalence/verification.json)、
[逐输入记录](../results/task_equivalence/replay.json)及该目录中的参考数组和原日志均已保存。

## 当前完成状态：四组时序与功耗评估均已完成

2026-10-17补齐四组布局布线。完整顶层包含原计算核心和相同32位评估接口，
权重在运行时加载，四组计算源码与各自综合快照一致。

| 模型 | 建立时间余量 | 保持时间余量 | 脉宽余量 | 布线后LUT | 布线后FF | DSP | BRAM36等效 |
| --- | ---: | ---: | ---: | ---: | ---: | ---: | ---: |
| 全有状态 | +0.070 ns | +0.005 ns | +2.583 ns | 29,894（42.37%） | 17,142（12.15%） | 308（85.56%） | 170.5（78.94%） |
| 仅L1无状态 | +0.021 ns | +0.010 ns | +2.583 ns | 29,544（41.87%） | 17,130（12.14%） | 308（85.56%） | 132.5（61.34%） |
| L1～L2无状态 | +0.071 ns | +0.011 ns | +2.583 ns | 29,546（41.87%） | 17,113（12.13%） | 308（85.56%） | 122（56.48%） |
| L1～L3无状态 | +0.080 ns | +0.013 ns | +2.583 ns | 29,287（41.51%） | 17,097（12.11%） | 308（85.56%） | 120（55.56%） |

2026-10-18 15:46，功耗流程完成：四组各自权重、同一user10的16个validation输入，
布线后功能网表运行真实输入，记录推理期间实际线网的信号变化，生成SAIF，
交给Vivado估算动态功率和芯片静态功率。每样本能量按该窗口的功率乘时间计算。
固定结温25°C、典型工艺、器件标称电压；权重和输入加载时间单列。
下表为16个样本的均值；总功率与总能量包含该实现的动态部分和器件静态部分。

| 模型 | 推理总功率 | 动态功率 | 每样本总能量 | 相对全状态节省总能量 |
| --- | ---: | ---: | ---: | ---: |
| 全有状态 | 0.611188 W | 0.389750 W | 402.257 µJ | 0% |
| 仅L1无状态 | 0.586062 W | 0.364938 W | 331.583 µJ | 17.57% |
| L1～L2无状态 | 0.579625 W | 0.358625 W | 285.527 µJ | 29.02% |
| L1～L3无状态 | 0.573000 W | 0.352000 W | 258.212 µJ | 35.81% |

每样本总能量的样本间标准差依次为6.038、4.680、3.779、3.353 µJ。
这组比较覆盖user10；输入相同，各组加载各自训练的权重。功率为工具估算，
输入加载、主机和板卡外设未纳入推理能量。24用户功耗平均不列入本篇必做实验。
本篇未加入逐线SDF传播延时，未统计延迟差产生的短暂跳变；完整160MHz时序检查已经通过。
此前额外安排的延迟仿真已停止，额外产物按用户要求删除。

完整证据目录：`results/implementation/`及`results/power/`。
完成状态见`results/completion.json`，主表为`results/summary.json`。
复现入口见[复现说明](reproduction.md)，证据范围见[结果索引](../results/README.md)。

## 模型来源与固定条件

在carbon的`/data/xuzx/result/ebv-eye/pursuit/fixed_event_window/snn/`找到四组，
每组24个用户，均为Pursuit、eye0、seed2021、T=2重复完整400事件图、正式aligned缓存。
四组从每个用户相同的全状态第100轮训练状态分别继续训练至200轮，
最佳checkpoint均由各自验证集选取。四组共96份配置、摘要与checkpoint校验值已核对；
本次硬件数值验证使用同一个user10，四组各自的权重，保持输入与用户不变。

| 模型 | user10最佳轮次 | user10浮点test角误差 | user10定点test角误差 | 24用户浮点test等权平均 | 24用户定点test等权平均 |
| --- | ---: | ---: | ---: | ---: | ---: |
| 全有状态 | 187 | 0.498069° | 0.508845° | 0.812552° | 0.810896° |
| 仅L1无状态 | 195 | 0.486772° | 0.492321° | 0.814904° | 0.816982° |
| L1～L2无状态 | 198 | 0.490071° | 0.506021° | 0.823945° | 0.825481° |
| L1～L3无状态 | 184 | 0.532882° | 0.529313° | 0.826896° | 0.823448° |
| L1～L4无状态 | 198 | 0.511031° | 0.502631° | 0.834131° | 0.832797° |

user10定点精度覆盖各组全部1194个test窗口。24用户浮点均值来自既有训练结果，每位用户等权。
2026-10-18核对服务器已有10月12日量化批次，L1～L2无状态的24用户、25,716个完整test输入
早已完成量化；24份模型权重、配置和缓存清单记录与当前模型审计全部一致。
该组定点均值0.825481°，较浮点增加0.001536°；本地完整副本见
[24用户量化结果](../results/quantization/multiuser/results.json)。
2026-10-19在carbonite服务器CPU补齐其余三档：Pursuit新增69份、Saccade旧连续输出头新增72份，
复用并核对已有51份，共四档×两任务×24用户＝192份完整test量化结果。
新评估共158,733次测试推理；每份新模型先用一个真实输入，核对独立64位整数参考的61个逐层数组，
再遍历完整测试集。保存的预测坐标、逐样本误差、逐人均值及8组汇总均经独立程序复算通过，
原始模型和测试缓存SHA-256保持一致。浮点列保留原L40S训练报告，定点推理使用CPU。
本轮沿用相同16位数值规则，模型、训练、FPGA电路和功耗结果保持原样。
新增评估中8位脉冲限幅0次，24位电流限幅246次（L2为130次、L3为116次），
均按既定限幅规则计入下表精度；逐层计数保存在`execution.json`。

| 无状态层 | Pursuit浮点test角误差 | Pursuit定点test角误差 | Saccade浮点test角误差 | Saccade定点test角误差 |
| --- | ---: | ---: | ---: | ---: |
| 无，全有状态 | 0.812552° | 0.810896° | 1.321090° | 1.322249° |
| L1 | 0.814904° | 0.816982° | 1.321644° | 1.314573° |
| L1～L2 | 0.823945° | 0.825481° | 1.325509° | 1.326037° |
| L1～L3 | 0.826896° | 0.823448° | 1.333435° | 1.326348° |
| L1～L4 | 0.834131° | 0.832797° | 1.350088° | 1.342359° |

两任务均为user4～27、eye0、seed2021、T2重复完整400事件、aligned数据；
每位用户先求完整test平均，再对24人等权平均。每档Pursuit共25,716个测试样本，
Saccade共28,389个；Saccade沿用论文连续xy输出。
本批[完整结果](../results/quantization/state_depth/results.json)、
[独立核验](../results/quantization/state_depth/verification.json)和输入、源码快照随结果保存。
新增第五档另保存于`quantization/l1_l4/`（Pursuit）和`quantization/saccade_l1_l4/`（Saccade），
五档现均有双任务各24用户完整test结果。
量化使用16位权重与膜电位、24位完整卷积结果、8位脉冲数、逐输出通道缩放，alpha为0.75。

L1～L2组的checkpoint SHA-256为
`0bb7b80559af2dd0fe53188c5f720c192a2343ca571975e31f5e8d04116cfeb6`，
与已有正式模型完全相同；下载后的全部定点参数数组和参考数组与正式版逐项一致。

## 四组使用同一条复用规则

计算阵列、数值位宽、网络尺寸、权重加载接口和逐层连续处理两个时间步的顺序相同。
前面连续无状态的层计算一次；第一层有状态层复用相同的卷积/池化结果，
分别执行两次神经元运算，并在两步之间保存和读取膜电位；再后面的层完整计算两步。

| 模型 | 完整输出只算一次的层 | 卷积结果复用、神经元计算两步的层 |
| --- | --- | --- |
| 全有状态 | 无 | L1 |
| 仅L1无状态 | L1 | L2 |
| L1～L2无状态 | L1、L2 | L3 |
| L1～L3无状态 | L1、L2、L3 | L4 |

全有状态组两步输入也相同，所以L1的卷积可以复用，两个时间步的神经元状态照常更新。
四组都通过运行时接口加载权重，综合时没有将某个模型权重写成固定电路常量。
片上存储按各组所需的第二步特征、膜电位、分段累加结果和复用电流配置。

## 已核验的核心拍数

| 模型 | 核心拍数 | 160 MHz通过时序后的核心时间 | 相对本轮全有状态组减少 |
| --- | ---: | ---: | ---: |
| 全有状态 | 105,305 | 0.658156 ms | 0% |
| 仅L1无状态 | 90,525 | 0.565781 ms | 14.04% |
| L1～L2无状态 | 78,817 | 0.492606 ms | 25.15% |
| L1～L3无状态 | 72,101 | 0.450631 ms | 31.53% |

拍数由RTL回放得到，每组16个样本全部相同。时间按`拍数 / 160000000`计算，
仅包括输入和权重已装入片上存储后的核心计算，不包含事件采集、计数图准备和输入传输。
本轮四组均已完成布局布线并通过160 MHz完整时序检查。
当前采用四版本同接口实现作为论文比较基准。

| 层 | 全有状态 | 仅L1无状态 | L1～L2无状态 | L1～L3无状态 |
| --- | ---: | ---: | ---: | ---: |
| L1 | 15,855 | 12,779 | 12,779 | 12,779 |
| L2 | 26,588 | 14,884 | 13,340 | 13,340 |
| L3 | 21,761 | 21,761 | 11,597 | 11,009 |
| L4 | 13,174 | 13,174 | 13,174 | 7,046 |
| L5 | 8,187 | 8,187 | 8,187 | 8,187 |
| L6～L8，每层 | 5,217 | 5,217 | 5,217 | 5,217 |

本轮全有状态组同样应用L1卷积复用，为105,305拍；
L1～L2组相对这组基线的时间节省为25.15%。

## FPGA综合资源

四组均在本机Vivado 2025.2.1上对同一`xczu3eg-sfvc784-2-e`器件运行完整顶层综合，
使用相同的32位寄存器接口、全局时钟与引脚约束。下表均为综合后资源。

| 模型 | LUT，逻辑单元 / 70,560 | FF，寄存器位 / 141,120 | DSP，专用计算块 / 360 | BRAM，36Kb等效块 / 216 |
| --- | ---: | ---: | ---: | ---: |
| 全有状态 | 30,228（42.84%） | 17,120（12.13%） | 308（85.56%） | 170.5（78.94%） |
| 仅L1无状态 | 29,952（42.45%） | 17,102（12.12%） | 308（85.56%） | 132.5（61.34%） |
| L1～L2无状态 | 29,909（42.39%） | 17,088（12.11%） | 308（85.56%） | 122（56.48%） |
| L1～L3无状态 | 29,917（42.40%） | 17,077（12.10%） | 308（85.56%） | 120（55.56%） |

实际36Kb块＋18Kb块分别为159＋23、117＋31、107＋30、105＋30。
18Kb块按半个36Kb块折算。逻辑和寄存器数量接近，DSP相同；
相对本轮全有状态组，后三组的整网BRAM分别减少22.29%、28.45%、29.62%。

L1～L2无状态相对本轮全有状态组，核心拍数减少25.15%、整网BRAM减少28.45%。
继续将L3无状态，相对L1～L2组再减少8.52%拍数、1.64%BRAM；
user10定点test角误差从0.506021°变为0.529313°，增加约0.0233°。
24用户浮点test等权均值从0.823945°变为0.826896°。

上表保留综合阶段原始资源；本轮后续的布局布线资源和时序已列于本报告首节。
功耗估算已完成，结果见本报告首节。四版本采用同样的时钟、接口和检查条件。

## 数值和源码验证

服务器已有环境完成四份模型量化与独立整数参考，下载到本机后进行RTL核验和综合。
每组16个相同validation输入，四组共64次整网RTL回放；累计12,340,224个中间值
及128个最终输出全部正确，膜电位读写和乘加发射次数逐层核对通过。
各组参考在生成时还与独立64位整数计算逐值比较，每组4,320,032值全部一致。

| 模型 | RTL核对中间值总数 | 失配 |
| --- | ---: | ---: |
| 全有状态 | 4,320,000 | 0 |
| 仅L1无状态 | 3,140,352 | 0 |
| L1～L2无状态 | 2,550,528 | 0 |
| L1～L3无状态 | 2,329,344 | 0 |

无状态层第二步复用第一步特征，RTL仅发出一次该层结果；生成标准答案时已经核对
这些层两个时间步的卷积结果、脉冲和膜电位逐项相同。
原四档测量使用的RTL原字节保存在`results/provenance/measured_sources.zip`，
测试台原文另在`four_depth_sources.zip`。当前`hardware/rtl/`在相同参数化核心中增加深度4；
原四档DCP、报告与测量校验值不变。

## 证据与复现

- [完整资源、时序、功率、能量总表](../results/summary.json)。
- [论文CSV表](../results/paper_metrics.csv)。
- [96份训练端点审计](../results/model_audit.json)。
- [四份选定模型与量化导出来源](../results/provenance/model_export.json)。
- [64次RTL回放](../results/rtl/report.json)及[64次布线后活动验证](../results/power/simulation_summary.json)。
- [综合检查点与报告](../results/synthesis/)。
- [最终布线检查点与报告](../results/implementation/)。
- [64份功耗与压缩活动](../results/power/)。
- [现成24用户量化结果](../results/quantization/multiuser/results.json)。
- [四档双任务24用户完整量化结果](../results/quantization/state_depth/results.json)。
- [复现说明](reproduction.md)。
