zen5x5/ebv-eye_snn_hardware/docs/verification.md

# 整理后的独立运行核验

核验日期：2026-10-18。四版本原实验结果保持不变，本次检查文件完整性、路径独立性和整理后的运行入口。

## 已完成的检查

| 整理后RTL回放，validation样本0 | 核对中间值数 | 核心拍数 | 数值失配 |
| --- | ---: | ---: | ---: |
| 全状态 | 270,000 | 105,305 | 0 |
| L1无状态 | 196,272 | 90,525 | 0 |
| L1～L2无状态 | 159,408 | 78,817 | 0 |
| L1～L3无状态 | 145,584 | 72,101 | 0 |

上述四次回放使用本仓库的10份RTL、模型权重镜像、输入和测试程序，在Vivado 2025.2.1完成。

- 两个单元测试通过：全部64个验证输入的.mem文件从随附NPZ恢复后，与原始逐文件SHA-256一致；四版本各一个样本的独立整数参考与原始逐层数组一致。
- 重新打包主设计定点参数，生成的7份.mem权重与原始硬件镜像逐字节一致。
- Python代码语法检查通过。
- 10份计算与接口RTL保留原字节，通过原实现报告记录的源码校验值检查。

## 保留的原实验

原64次RTL整网核验检查12,340,224个中间值及128个最终输出，全部通过。
四组最终布局布线检查点、资源与完整时序报告、64份布线后功能仿真日志、
活动文件和功耗报告均随项目保存。大活动文件采用gzip无损压缩。

文件总清单为MANIFEST.sha256；整理前来源与原始哈希为results/provenance/files.json。
python scripts/verify.py --full同时检查当前文件、原始证据字节、完整时序结论和功耗均值。
论文指标可由python scripts/report.py直接导出，取数不需要重新仿真或综合。
