zen5x5/ebv-eye_snn_hardware/results/latency_bram.csv

variant | stateless_depth | core_cycles | frequency_mhz | core_latency_ms | bram36_equivalent
full_state | 0 | 105305 | 160 | 0.65815625 | 170.5
l1_stateless | 1 | 90525 | 160 | 0.56578125 | 132.5
l1_l2_stateless | 2 | 78817 | 160 | 0.49260625 | 122.0
l1_l2_l3_stateless | 3 | 72101 | 160 | 0.45063125 | 120.0
l1_l2_l3_l4_stateless | 4 | 68293 | 160 | 0.42683125 | 120.0
