zen5x5/ebv-eye_snn_hardware/results/power_vectorless/summary.csv

variant | stateless_depth | core_cycles | core_ms | total_w | dynamic_w | device_static_w | total_energy_uj | confidence
full_state | 0 | 105305 | 0.65815625 | 0.733 | 0.511 | 0.221 | 482.42853125 | Low
l1_stateless | 1 | 90525 | 0.56578125 | 0.595 | 0.374 | 0.221 | 336.63984375 | Low
l1_l2_stateless | 2 | 78817 | 0.49260625 | 0.602 | 0.381 | 0.221 | 296.54896249999996 | Low
l1_l2_l3_stateless | 3 | 72101 | 0.45063125 | 0.604 | 0.383 | 0.221 | 272.181275 | Low
l1_l2_l3_l4_stateless | 4 | 68293 | 0.42683125 | 0.691 | 0.47 | 0.221 | 294.94039375 | Low
