zen5x5/ebv-eye_snn_hardware/hardware/vivado/constraints.xdc

# Evaluation-only pin assignment. Do not program an AUP-ZU3 with this pinout.
create_clock -name compute_clock -period 6.250 [get_ports clk]
set_property PACKAGE_PIN K4 [get_ports clk]
set_property IOSTANDARD LVCMOS18 [get_ports *]

set_property PACKAGE_PIN AB1 [get_ports {host_address[0]}]
set_property PACKAGE_PIN AB2 [get_ports {host_address[1]}]
set_property PACKAGE_PIN AB3 [get_ports {host_address[2]}]
set_property PACKAGE_PIN AB4 [get_ports {host_address[3]}]
set_property PACKAGE_PIN AB5 [get_ports {host_address[4]}]
set_property PACKAGE_PIN AB6 [get_ports {host_address[5]}]
set_property PACKAGE_PIN AB7 [get_ports {host_address[6]}]
set_property PACKAGE_PIN AB8 [get_ports {host_address[7]}]
set_property PACKAGE_PIN AC1 [get_ports {host_read_data[0]}]
set_property PACKAGE_PIN AC2 [get_ports {host_read_data[10]}]
set_property PACKAGE_PIN AC6 [get_ports {host_read_data[11]}]
set_property PACKAGE_PIN AC7 [get_ports {host_read_data[12]}]
set_property PACKAGE_PIN AC8 [get_ports {host_read_data[13]}]
set_property PACKAGE_PIN AC9 [get_ports {host_read_data[14]}]
set_property PACKAGE_PIN AD1 [get_ports {host_read_data[15]}]
set_property PACKAGE_PIN AD2 [get_ports {host_read_data[16]}]
set_property PACKAGE_PIN AD7 [get_ports {host_read_data[17]}]
set_property PACKAGE_PIN AD9 [get_ports {host_read_data[18]}]
set_property PACKAGE_PIN AE2 [get_ports {host_read_data[19]}]
set_property PACKAGE_PIN AE3 [get_ports {host_read_data[1]}]
set_property PACKAGE_PIN AE4 [get_ports {host_read_data[20]}]
set_property PACKAGE_PIN AE7 [get_ports {host_read_data[21]}]
set_property PACKAGE_PIN AE8 [get_ports {host_read_data[22]}]
set_property PACKAGE_PIN AE9 [get_ports {host_read_data[23]}]
set_property PACKAGE_PIN AF1 [get_ports {host_read_data[24]}]
set_property PACKAGE_PIN AF2 [get_ports {host_read_data[25]}]
set_property PACKAGE_PIN AF3 [get_ports {host_read_data[26]}]
set_property PACKAGE_PIN AF8 [get_ports {host_read_data[27]}]
set_property PACKAGE_PIN AG1 [get_ports {host_read_data[28]}]
set_property PACKAGE_PIN AG3 [get_ports {host_read_data[29]}]
set_property PACKAGE_PIN AG4 [get_ports {host_read_data[2]}]
set_property PACKAGE_PIN AG5 [get_ports {host_read_data[30]}]
set_property PACKAGE_PIN AG6 [get_ports {host_read_data[31]}]
set_property PACKAGE_PIN AG8 [get_ports {host_read_data[3]}]
set_property PACKAGE_PIN AG9 [get_ports {host_read_data[4]}]
set_property PACKAGE_PIN AH1 [get_ports {host_read_data[5]}]
set_property PACKAGE_PIN AH2 [get_ports {host_read_data[6]}]
set_property PACKAGE_PIN AH3 [get_ports {host_read_data[7]}]
set_property PACKAGE_PIN AH4 [get_ports {host_read_data[8]}]
set_property PACKAGE_PIN AH6 [get_ports {host_read_data[9]}]
set_property PACKAGE_PIN AH7 [get_ports {host_write_data[0]}]
set_property PACKAGE_PIN AH8 [get_ports {host_write_data[10]}]
set_property PACKAGE_PIN AH9 [get_ports {host_write_data[11]}]
set_property PACKAGE_PIN H1 [get_ports {host_write_data[12]}]
set_property PACKAGE_PIN H2 [get_ports {host_write_data[13]}]
set_property PACKAGE_PIN H3 [get_ports {host_write_data[14]}]
set_property PACKAGE_PIN H4 [get_ports {host_write_data[15]}]
set_property PACKAGE_PIN H6 [get_ports {host_write_data[16]}]
set_property PACKAGE_PIN H7 [get_ports {host_write_data[17]}]
set_property PACKAGE_PIN H8 [get_ports {host_write_data[18]}]
set_property PACKAGE_PIN H9 [get_ports {host_write_data[19]}]
set_property PACKAGE_PIN J1 [get_ports {host_write_data[1]}]
set_property PACKAGE_PIN J2 [get_ports {host_write_data[20]}]
set_property PACKAGE_PIN J4 [get_ports {host_write_data[21]}]
set_property PACKAGE_PIN J5 [get_ports {host_write_data[22]}]
set_property PACKAGE_PIN J6 [get_ports {host_write_data[23]}]
set_property PACKAGE_PIN J7 [get_ports {host_write_data[24]}]
set_property PACKAGE_PIN J9 [get_ports {host_write_data[25]}]
set_property PACKAGE_PIN K1 [get_ports {host_write_data[26]}]
set_property PACKAGE_PIN K2 [get_ports {host_write_data[27]}]
set_property PACKAGE_PIN K5 [get_ports {host_write_data[28]}]
set_property PACKAGE_PIN K7 [get_ports {host_write_data[29]}]
set_property PACKAGE_PIN K8 [get_ports {host_write_data[2]}]
set_property PACKAGE_PIN K9 [get_ports {host_write_data[30]}]
set_property PACKAGE_PIN L1 [get_ports {host_write_data[31]}]
set_property PACKAGE_PIN L8 [get_ports {host_write_data[3]}]
set_property PACKAGE_PIN M8 [get_ports {host_write_data[4]}]
set_property PACKAGE_PIN N6 [get_ports {host_write_data[5]}]
set_property PACKAGE_PIN N7 [get_ports {host_write_data[6]}]
set_property PACKAGE_PIN N8 [get_ports {host_write_data[7]}]
set_property PACKAGE_PIN N9 [get_ports {host_write_data[8]}]
set_property PACKAGE_PIN P6 [get_ports {host_write_data[9]}]
set_property PACKAGE_PIN P7 [get_ports {host_write_enable}]
set_property PACKAGE_PIN P9 [get_ports {rst}]
set_input_delay -clock compute_clock -min 1.000 [get_ports -filter {DIRECTION == IN && NAME != clk}]
set_input_delay -clock compute_clock -max 1.000 [get_ports -filter {DIRECTION == IN && NAME != clk}]
set_output_delay -clock compute_clock -min 1.000 [all_outputs]
set_output_delay -clock compute_clock -max 1.000 [all_outputs]
